nailtosun/Thermal-Analysis/README.md

# Tübitak'a yazılacak rapor başlıkları
## Termal Toplu Öğeli Devre (Lumped parameter)
### Foster Model
### Cauer Model
## Konveksiyon Katsayısının Belirlenmesi
## Sonlu Elemanlar Analizinin Yapılması
## Termal Deneyle Sonlu Elemanlar Analizinin karşılaştırılması
