nailtosun/Thermal-Analysis/STAR-2018/Poster/Nail_Poster.pptx

Thermal Modelling of IMMD Structure and Heat-Sink Design

Nail Tosun
(nail.tosun@metu.edu.tr)

Abstract

The power losses on the motor drive circuit occur as thermal pressure on the motor drive. As a result, the temperature of the motor-driver board may increase and the drive may disturb the operation may cause permanent damage to the circuit elements (particularly transistors). A cooler must be used in order to effectively remove the heat energy generating from power losses. The aim of this project is to construct a thermal model and design a heatsink to 7.5kW Integrated Modular Motor Driver system. The physical properties of the cooler are important here. If the heat sink is produced longer than necessary, increased motor size causes a reduction in the power density. On the other hand, a heat sink designed shorter than necessary puts the operation at risk. In the heat sink design, lumped parameter thermal circuit modeling was performed at first, then the required thermal resistance of the heat sink is calculated as a result of the analysis on this model.

Thermal Path on Drive Side

Lumped Parameters and
Heat Sink Design

Since the heat sinks are quarter slice shaped instead of rectangular and the fan size is smaller than heat sink size
- L, air traveling distance
- V, air flow speeds
are different at each wing. Both variables are calculated by taking the average of all values. h was calculated as 18.36 W / m-K. According to this calculated value, the heat sink fin length was determined, appropriate aluminum profiles are taken accordingly and they were cut as desired by using water jet.

Mesut Uğur
(ugurm@metu.edu.tr)

PowerLab Research Group, METU, ANKARA

Ozan Keysan
(keysan@metu.edu.tr)

FEA and Test Results

Testing was carried out by using metal resistors on the heat sink and at the same time, model verification is tried to be done by using FEA. Metal resistors have a total power rating of 44.1 W. Measurements were recorded with a thermal camera at an ambient temperature of 18.3°C

Heat Convection Coefficient Calculations

Optimization of the fin height

Conclusion

Steady state analysis is carried out in only resistive network model for the thermal equivalent circuit modelling and calculating convection coefficient. Convection coefficient is computed first using lumped parameter method. According to this calculated value, the heat sink fin height was determined, appropriate aluminum profiles are taken accordingly and heat sinks are produced. Obtained results are tested and verified using FEA method. Further analysis and design is made again using FEA in order to obtain a smaller fin height value and increase the power density. Finally, comparing to the first result, an optimized and better result in terms of power density is obtained which is 2 cm.

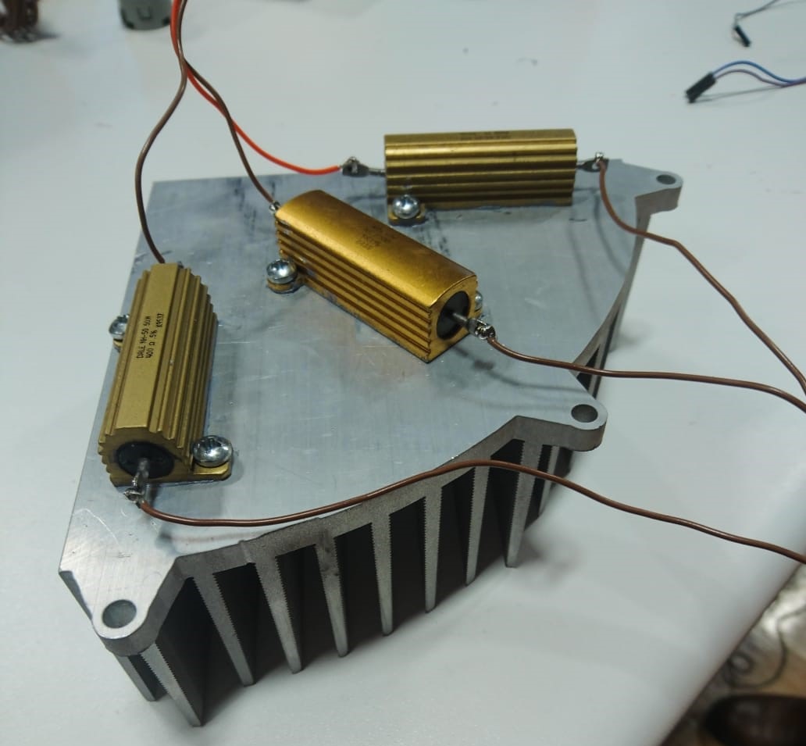
[picture p1: figure]

Test setup

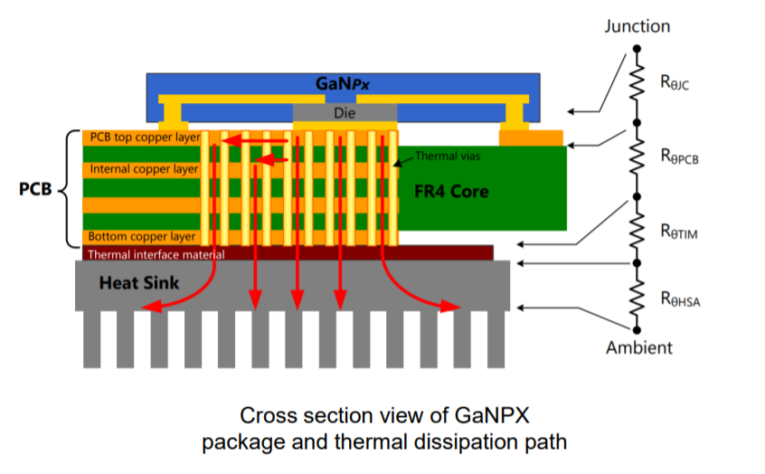
[picture p2: figure]

In this model, P_(loss) is the power loss of each GaN transistor, T_j , T_c , T_(pcb) , T_(hs) and T_a are junction, package, printed circuit board, cooler base and ambient temperature respectively. Resistances refer to the thermal resistance between the two points.

R_(hs) = 1/(h(A_(base) +N_(fin) η_(fin) A_(fin) ))

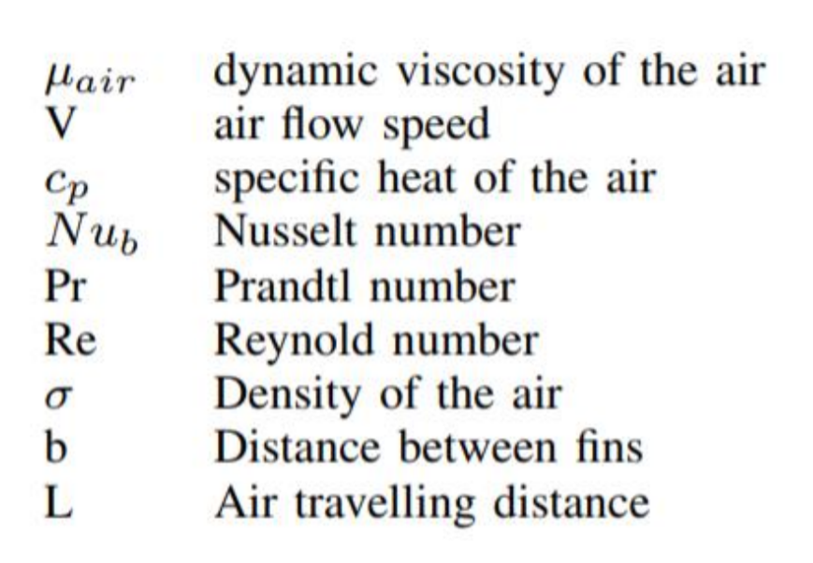
[picture p3: figure]
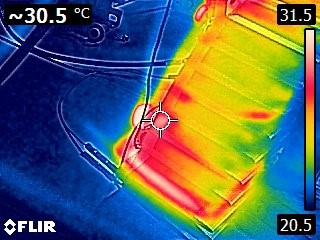
[picture p4: figure]
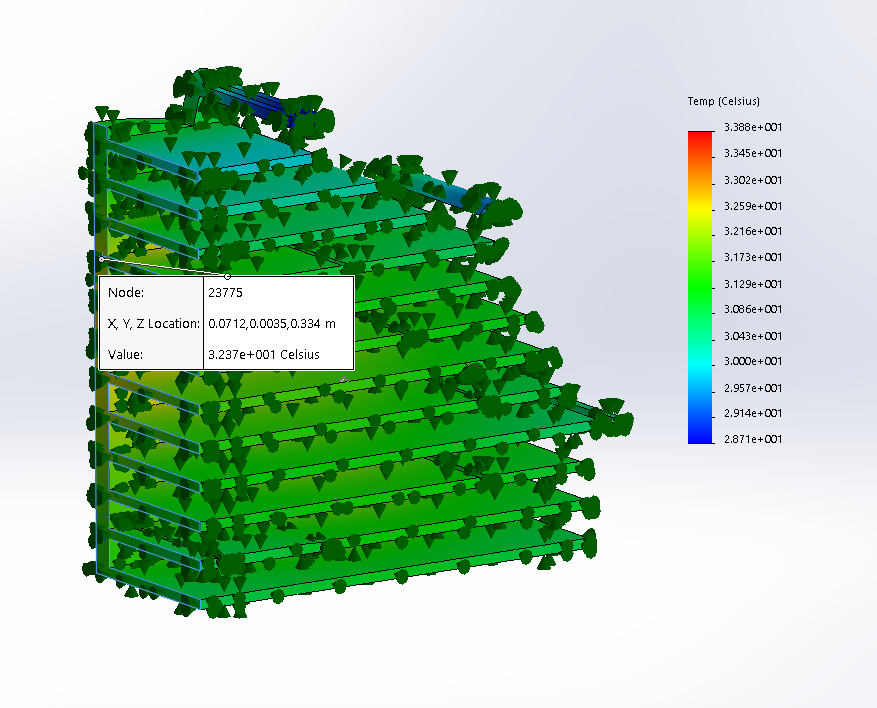
[picture p5: figure]
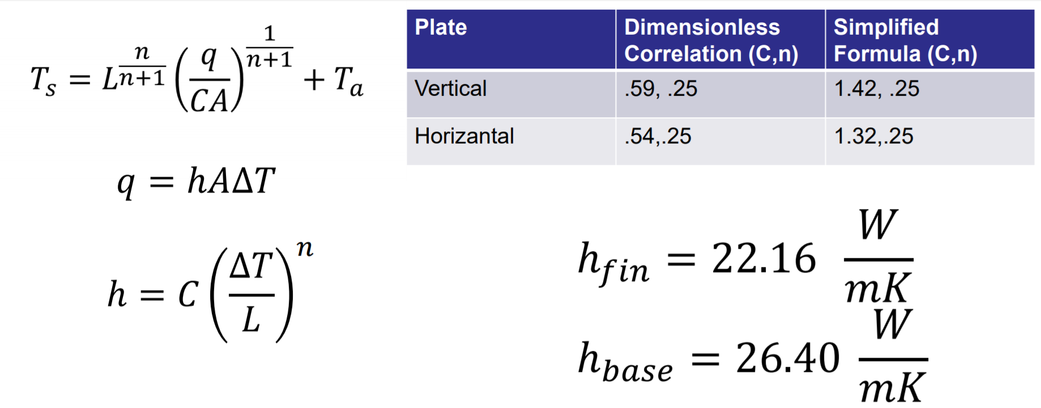
[picture p6: figure]

Test results

FEA results

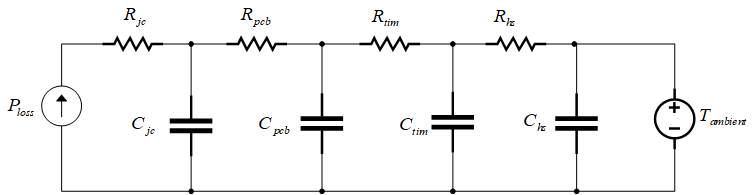
[picture p7: figure]
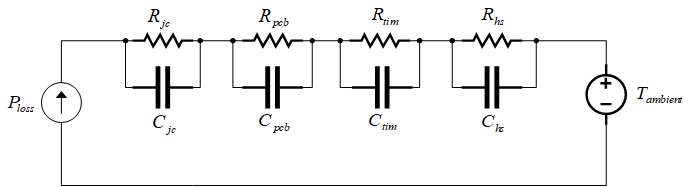
[picture p8: figure]

Cauer Model

Foster Model

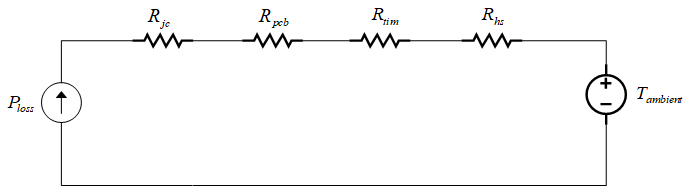
[picture p9: figure]

Only Resistive Network

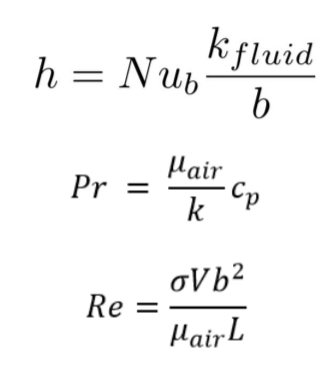
[picture p10: figure]

Constant C,n values

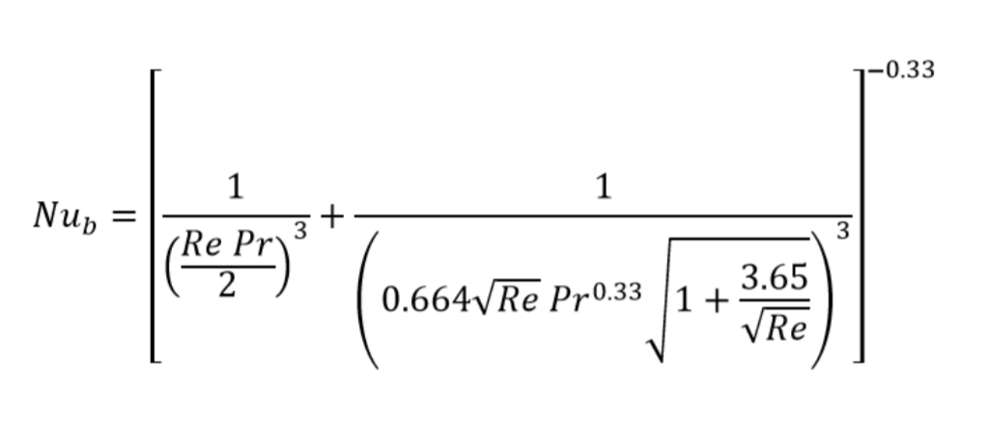
[picture p11: figure]
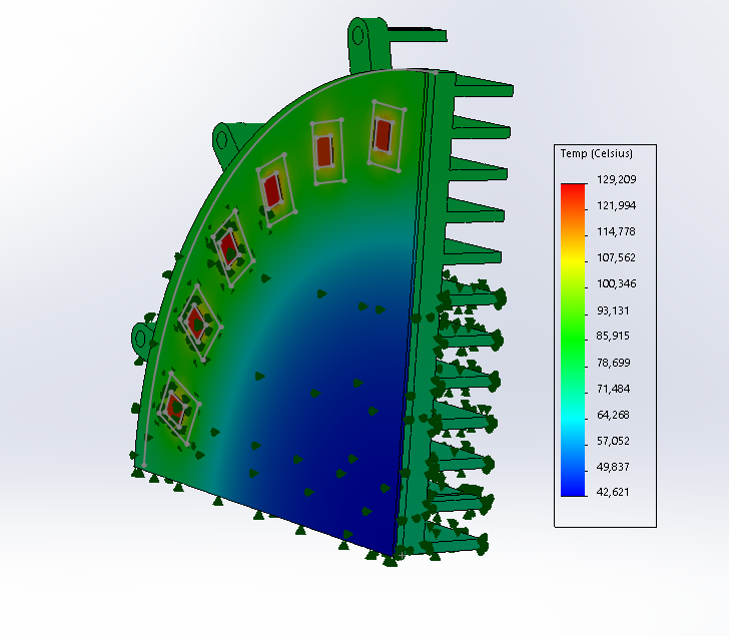
[picture p12: figure]
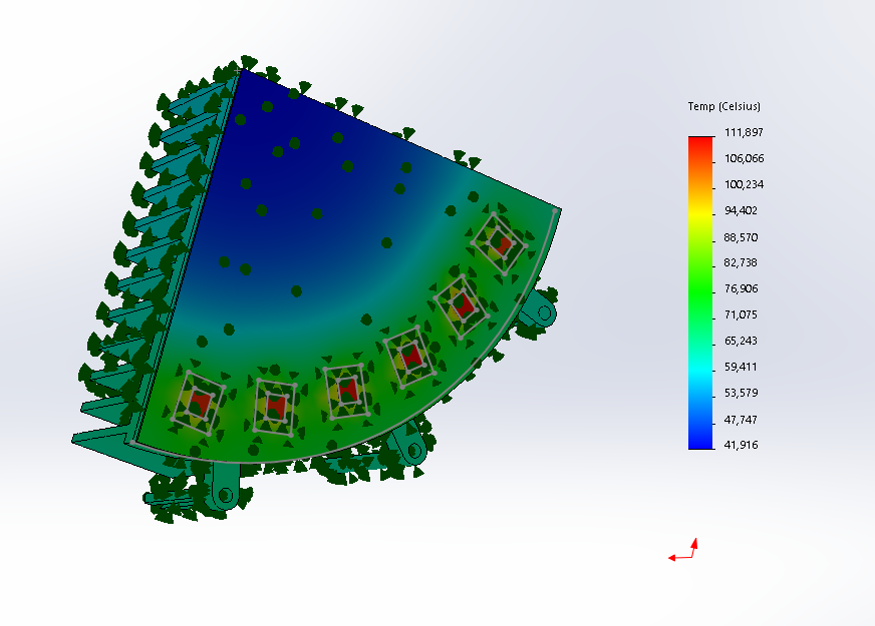
[picture p13: figure]
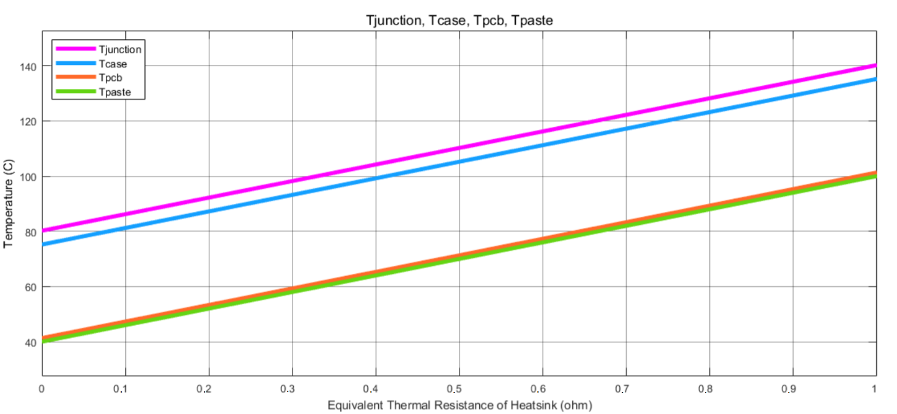
[picture p14: figure]
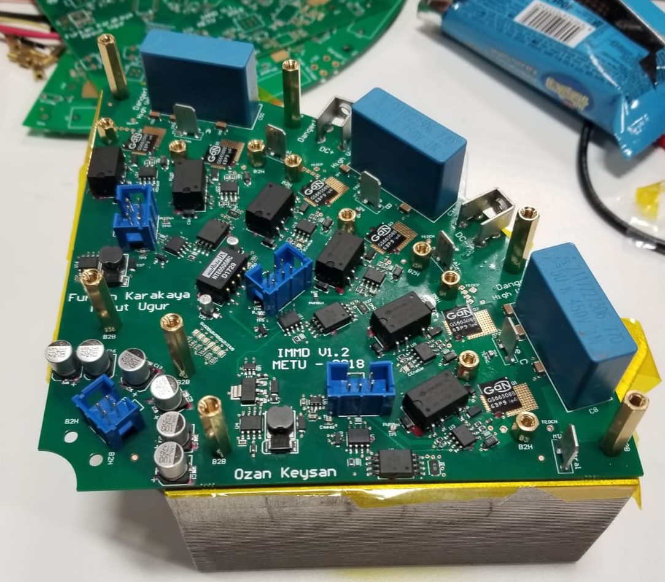
[picture p15: figure]

PCB with heat sink

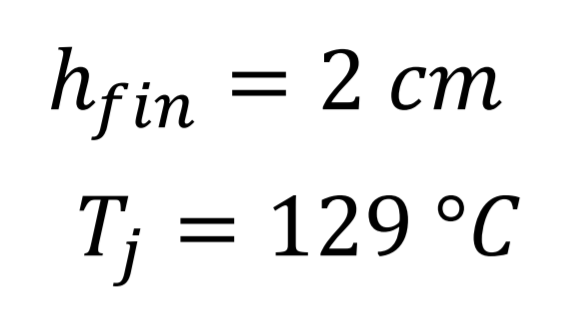
[picture p16: figure]
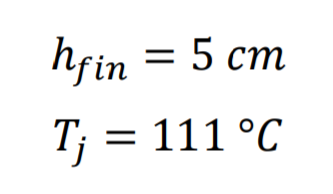
[picture p17: figure]

References

[1] GaN Systems, “PCB Thermal Design Guide for GaN Enhancement Mode Power Transistors” Application Notes, 2018.
[2] ncropera, F.P., and DeWitt, D.P., Fundamentals of Heat and Mass Transfer, John Wiley and Sons, New York, NY, 1985.
