nailtosun/Thermal-Analysis/22-04-presentation.pptx

## IMMD Termal Simülasyonu

## Fin height vs Heat Convection Coefficent

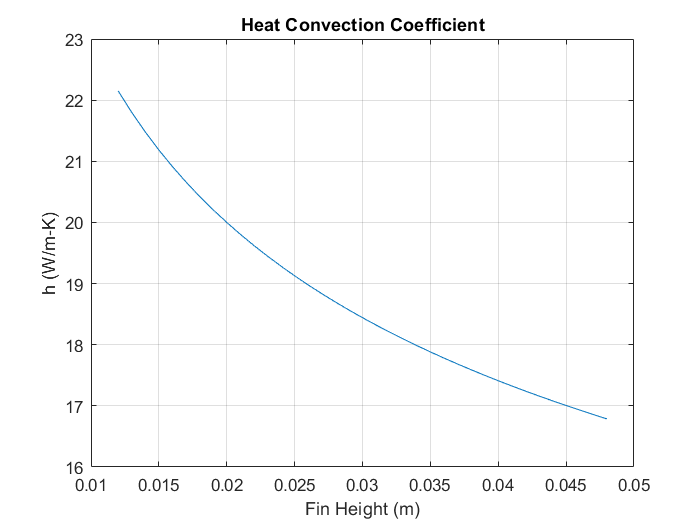
[picture p18: figure]
metin içeren bir resim Açıklama otomatik olarak oluşturuldu
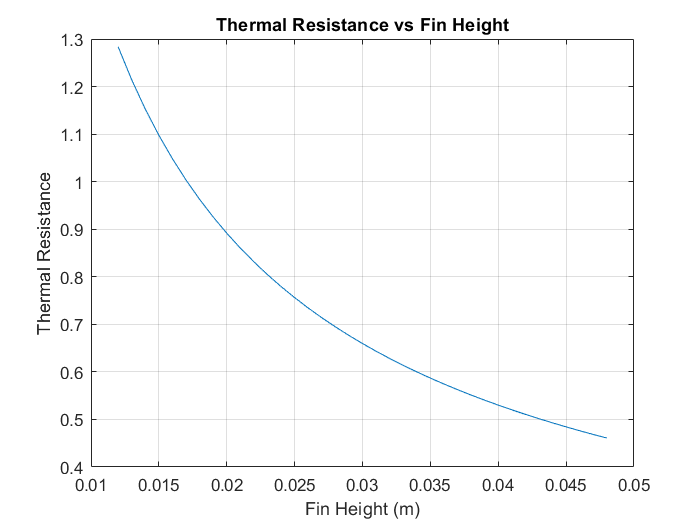
[picture p19: figure]
metin içeren bir resim Açıklama otomatik olarak oluşturuldu

## Study 1 (4.8 cm fin)

- hfin = 17 W/m-K
- Ambient temperature 20 Celcius
- Loss, 6,5 Watt per GaN

## Slide 4

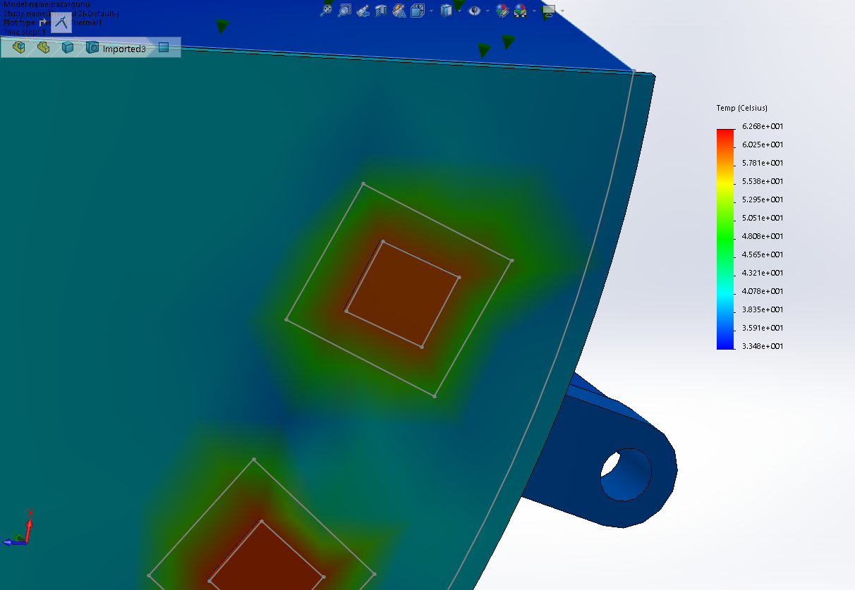
[picture p20: figure]
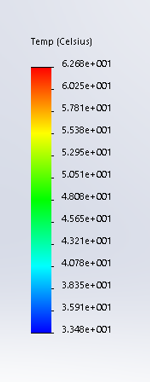
[picture p21: figure]

## Slide 5

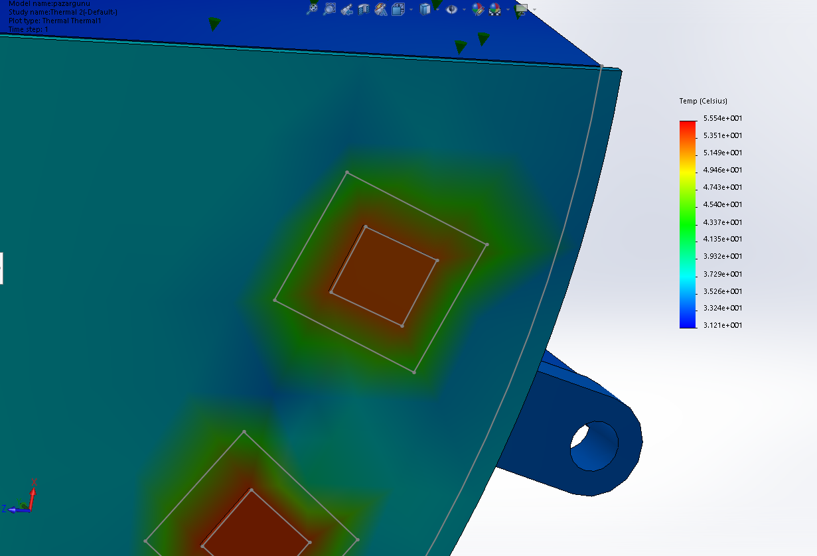
[picture p22: figure]
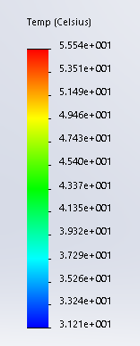
[picture p23: figure]

## Study 2 (4.8 cm fin)

- hfin = 17 W/m-K
- Ambient temperature 40 Celcius
- Loss, 5,4 Watt per GaN

## Slide 7

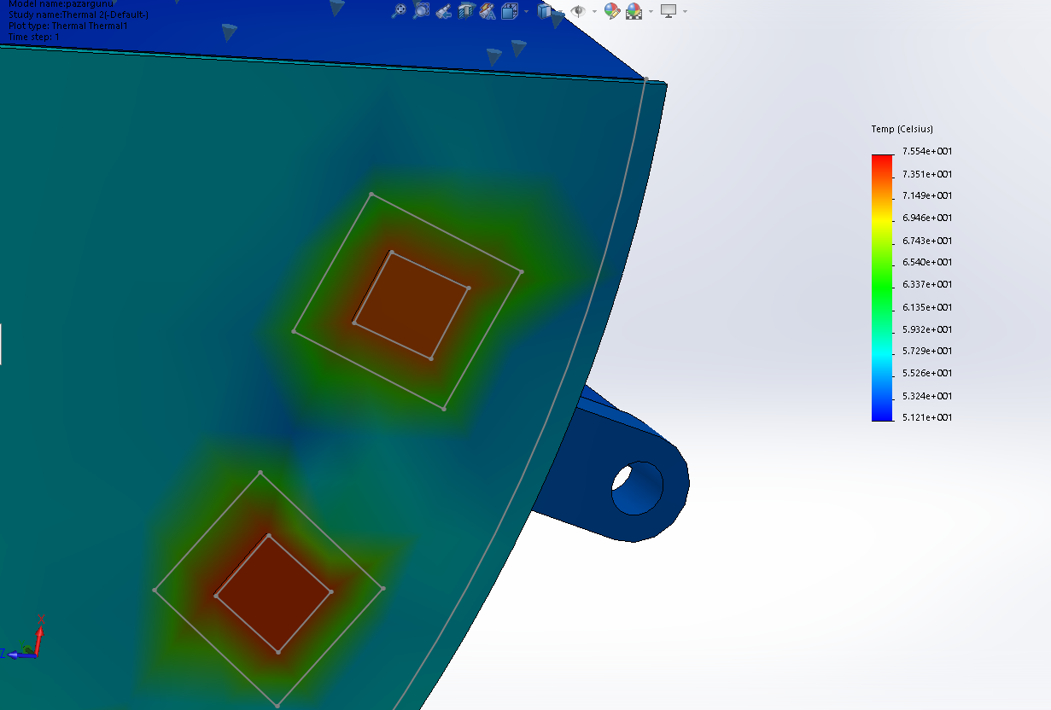
[picture p24: figure]
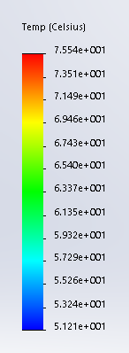
[picture p25: figure]

## Slide 8

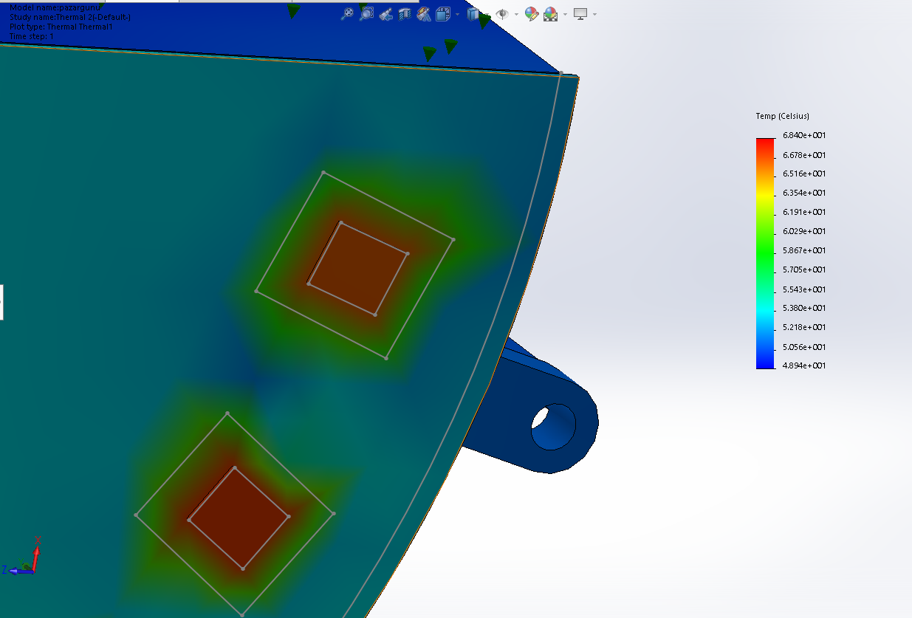
[picture p26: figure]

## Study 3 (2.4 cm fin)

- hfin = 19.2 W/m-K
- Ambient temperature 40 Celcius
- Loss, 6,5 Watt per GaN

## Slide 10

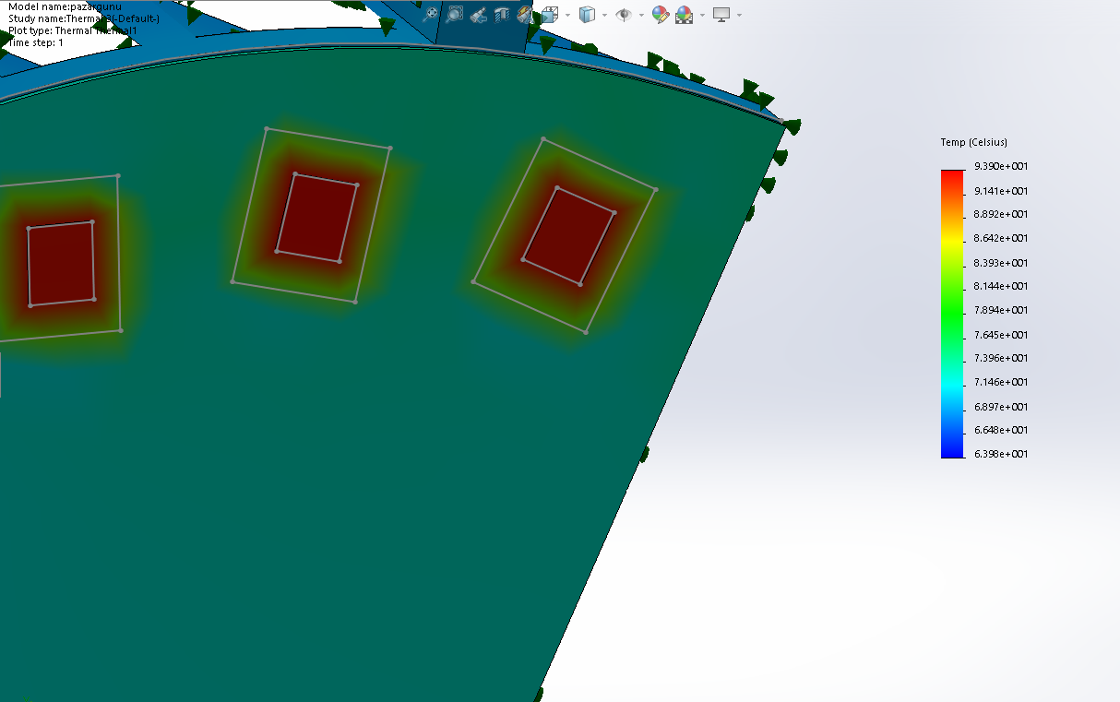
[picture p27: figure]
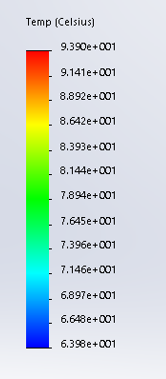
[picture p28: figure]

## Slide 11

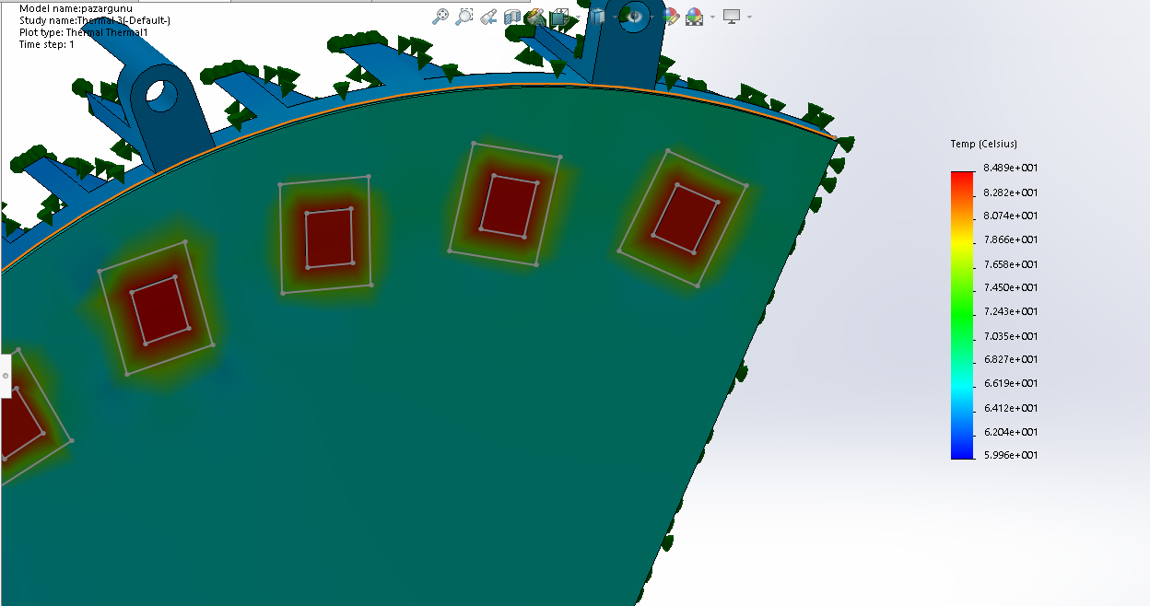
[picture p29: figure]
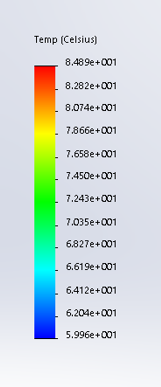
[picture p30: figure]
