nailtosun/Thermal-Analysis/FEA-1012.pptx

## Thermal FEA

## Slide 2

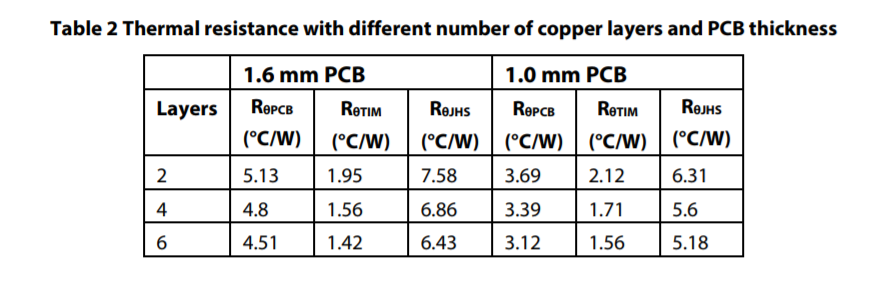
[picture p31: figure]
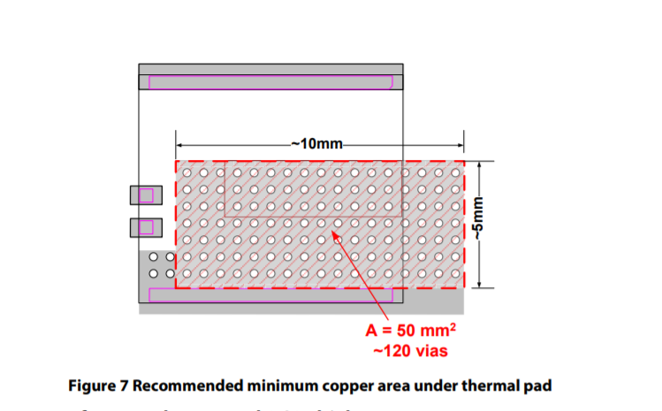
[picture p32: figure]

R_(pcb) =l/(ρA)

ρ=l/(R_(pcb) A)

ρ= 5.8997 W/m-K

## Slide 3

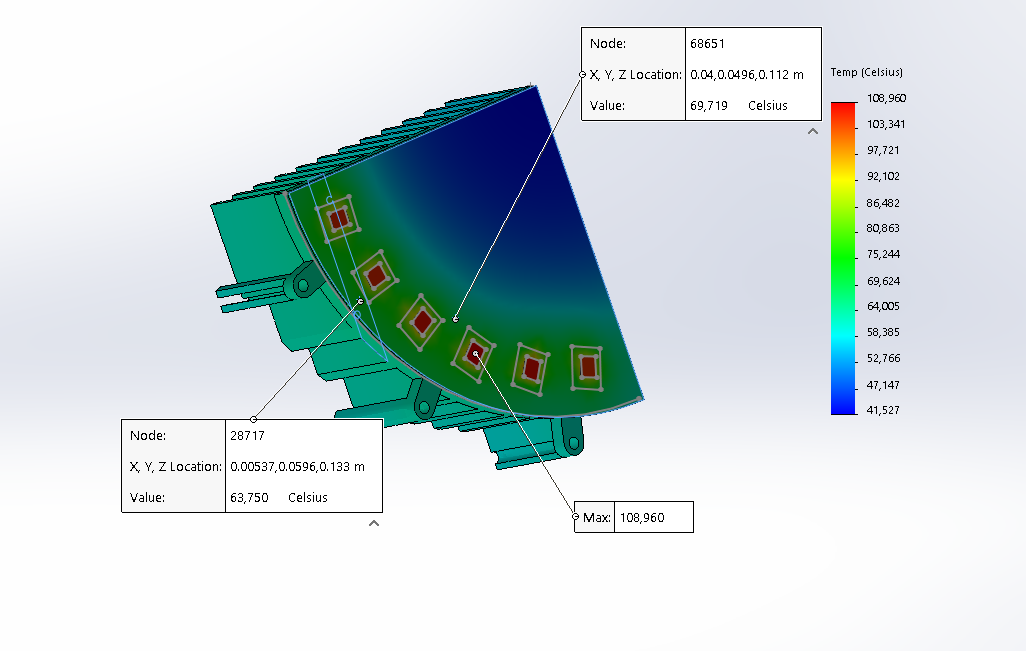
[picture p33: figure]

P_(GaN) =10 W

T_(amb) = 40 C^o

h_(fe) =18W/(m−K )

h_(be) =5W/(m−K )

## Slide 4

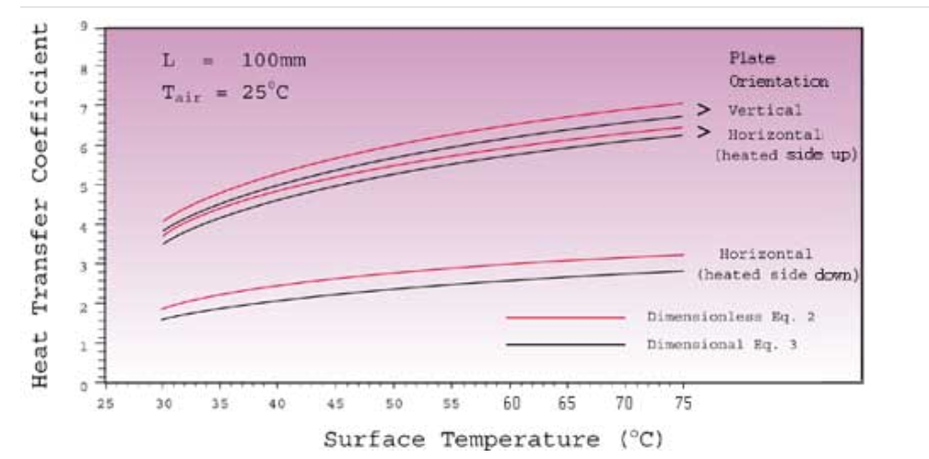
[picture p34: figure]

## Slide 5

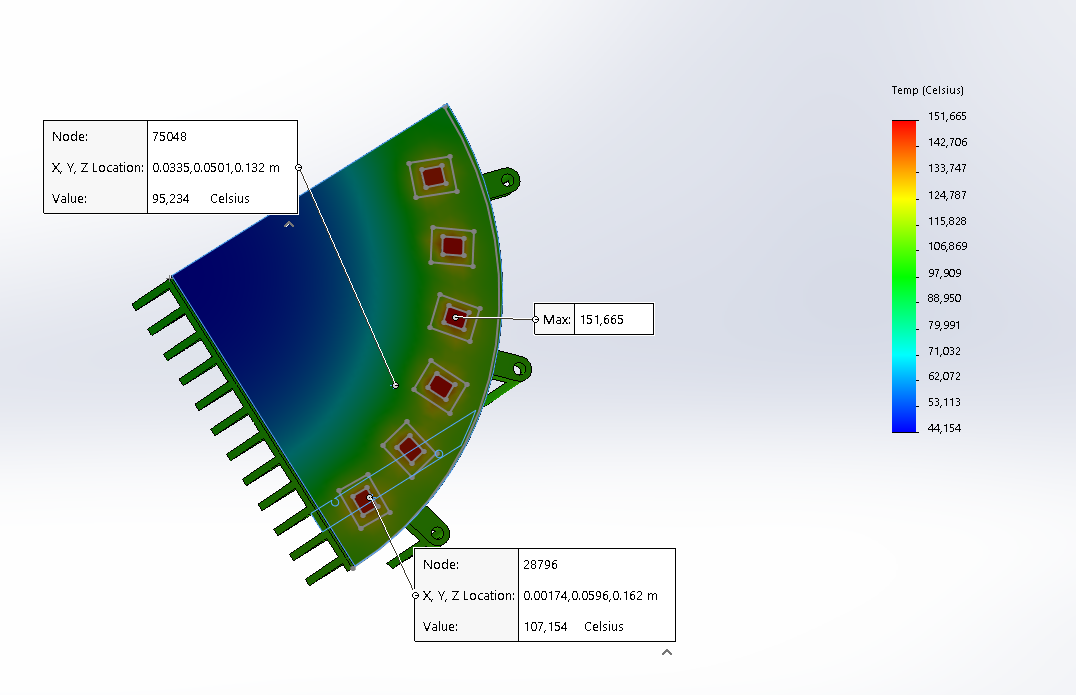
[picture p35: figure]

h_c =5W/(m−K )

P_(GaN) =10 W

T_(amb) = 40 C^o

## Slide 6

h_c =5W/(m−K )

P_(GaN) =10 W

T_(amb) = 40 C^o

## Slide 7

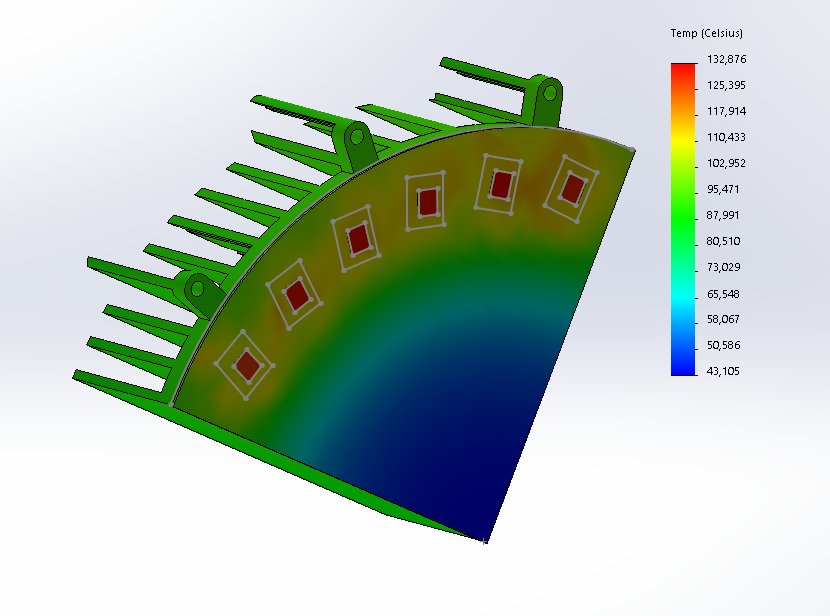
[picture p36: figure]

h_c =6W/(m−K )

P_(GaN) =10 W

T_(amb) = 40 C^o

## Estimating natural convection for heat-sink

- h_(fin)
- h_(base)

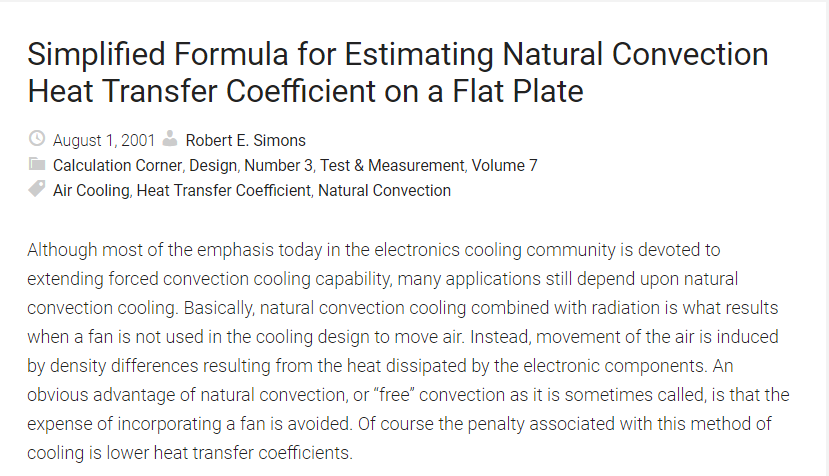
[picture p37: figure]
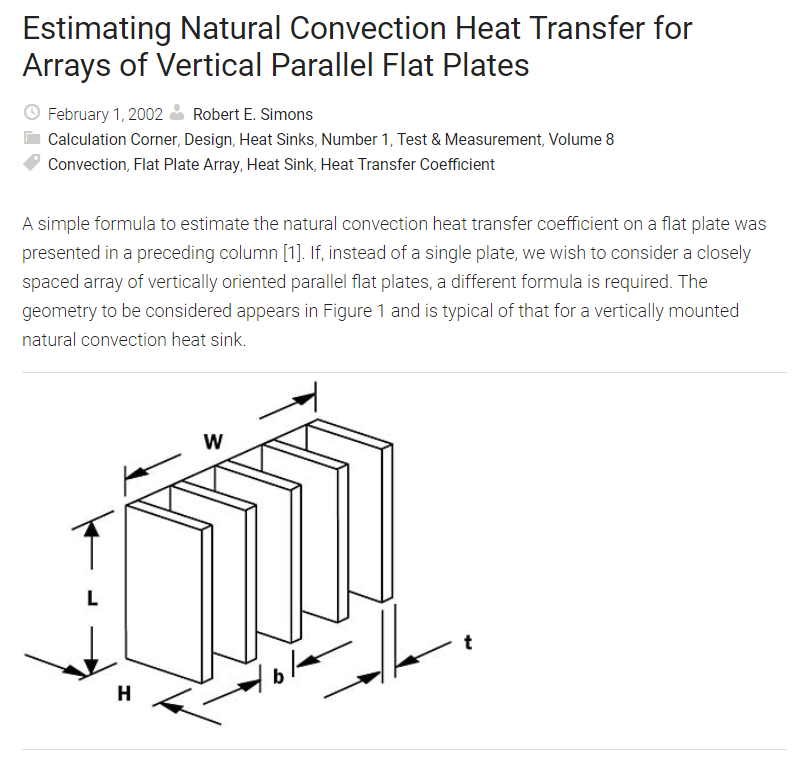
[picture p38: figure]

## Estimating natural convection for heat-sink

- Simplified Formula for h
- Dimensionless Correlation

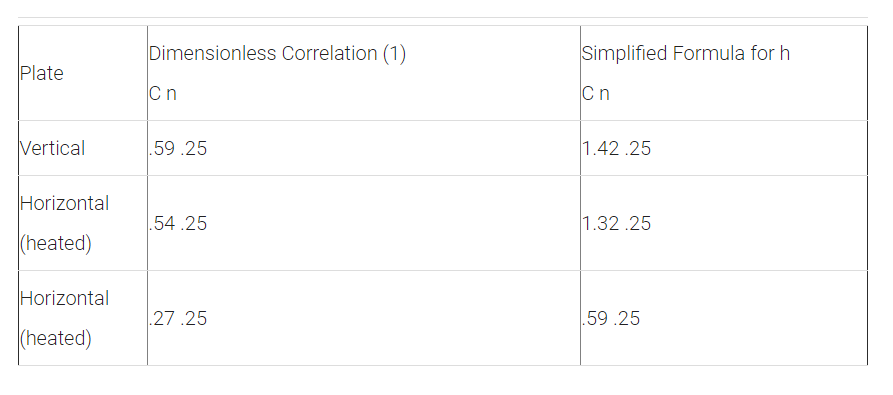
[picture p39: figure]

## Slide 10

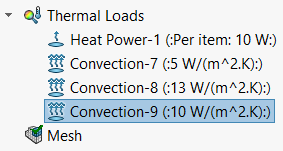
[picture p40: figure]
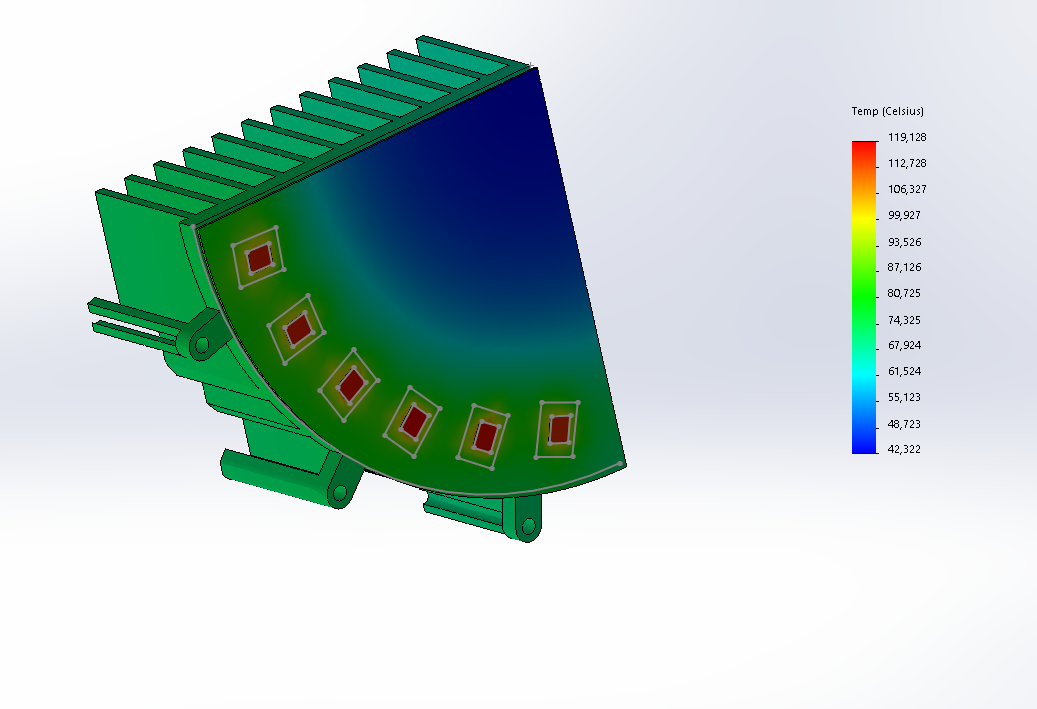
[picture p41: figure]
