nailtosun/Thermal-Analysis/Presentations/FEA-24-12.pptx

## The effect of Fin Height on Natural Convection Coefficient

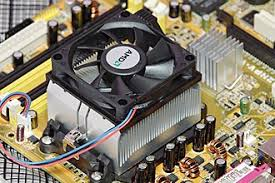
[picture p42: figure]
heat sink ile ilgili gÃ¶rsel sonucu

## Estimation of Natural Convection Flat surfaces (Base of the heat sink)

- Two method proposed
  - Dimensionless Number Correlations
    - Boundary condition (Surface temperature needed.)
  - Simplified formula (Comes from DNC &Newton rate equation)
    - Boundary condition estimated

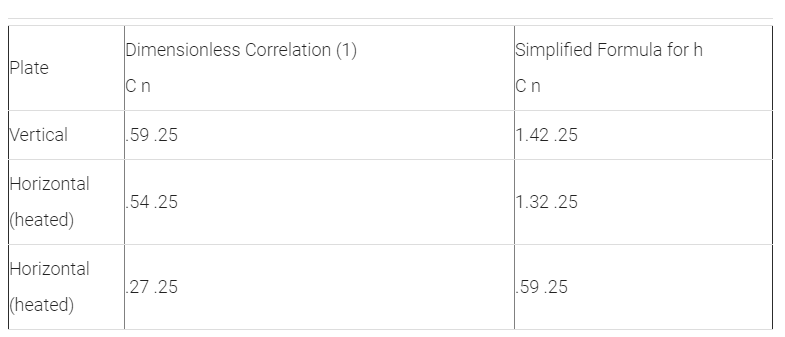
[picture p43: figure]

T_s = surface temperature

q = Heat power entering the surface

L = Vertical length of the solid

C and n are constants

## Estimation of Natural Convection Flat surfaces (Base of the heat sink)

- Last time I used DNC
  - Boundary conditions are guessed last time
- Now, surface temperature founded by simplified formula

Assumptions
- Fins are normalized
- All heat splitted equally

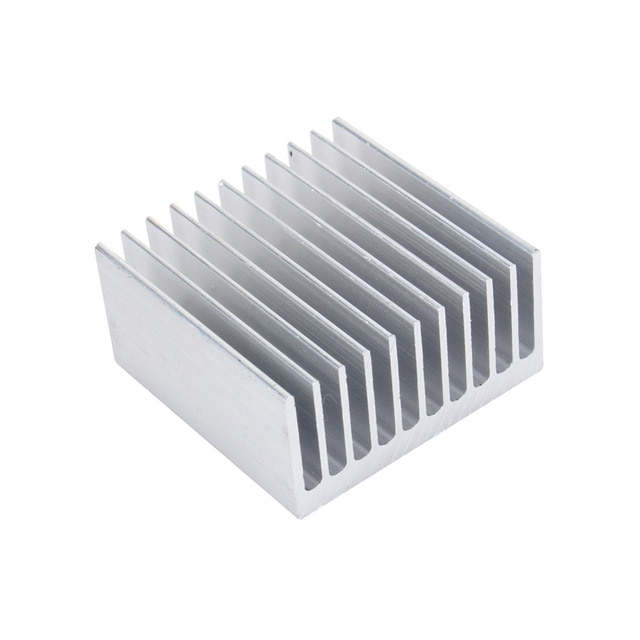
[picture p44: figure]
heat sink ile ilgili gÃ¶rsel sonucu

## Slide 4

With current geometry
  - h_(fin) =22.16 W/(mK)
  - h_(base) =26.40 W/(mK)

metin içeren bir resim Açıklama otomatik olarak oluşturuldu

The reason for fin efficieny?

metin içeren bir resim Açıklama otomatik olarak oluşturuldu

## Slide 5

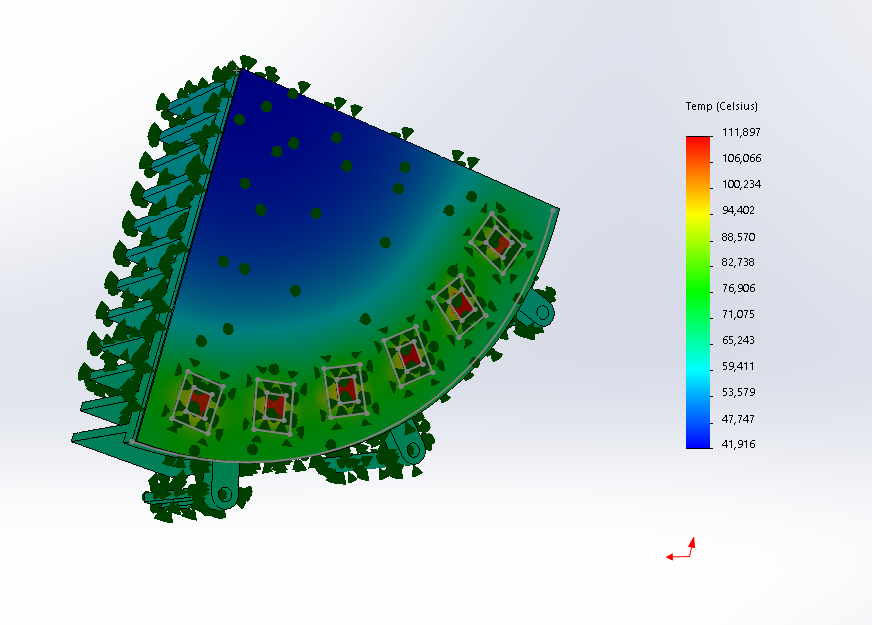
[picture p45: figure]
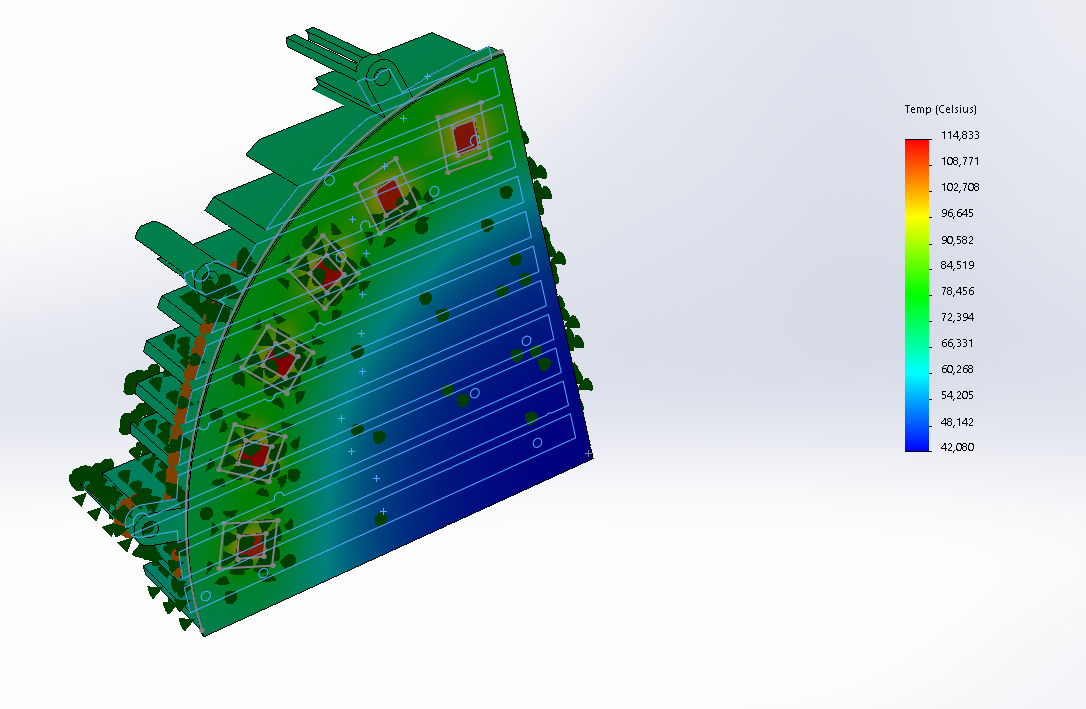
[picture p46: figure]

Fin height = 4.8 cm

Fin height = 3.8 cm

## Slide 6

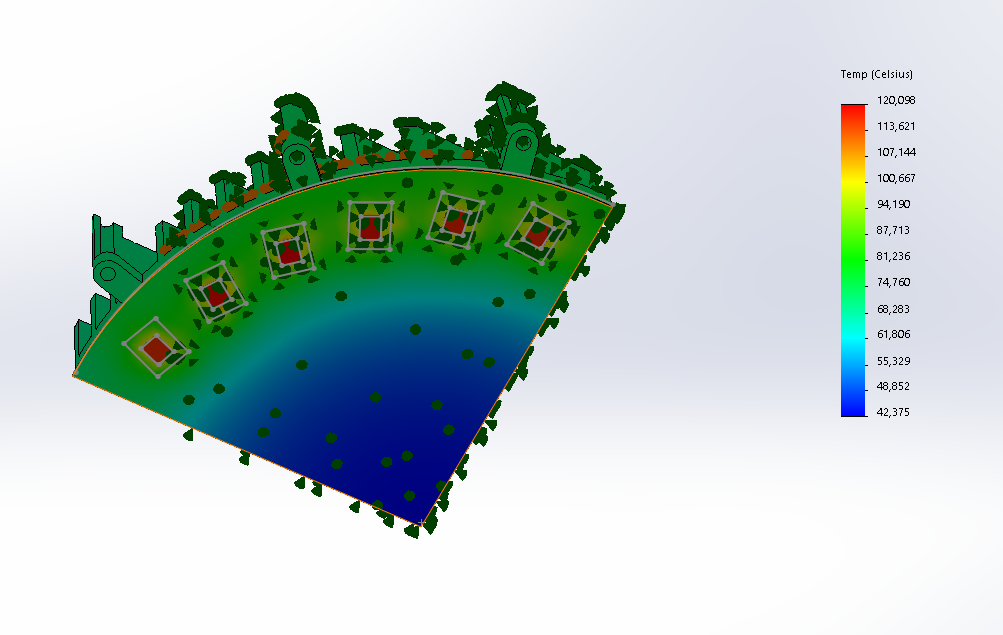
[picture p47: figure]

Fin height = 2.8cm

## Slide 7

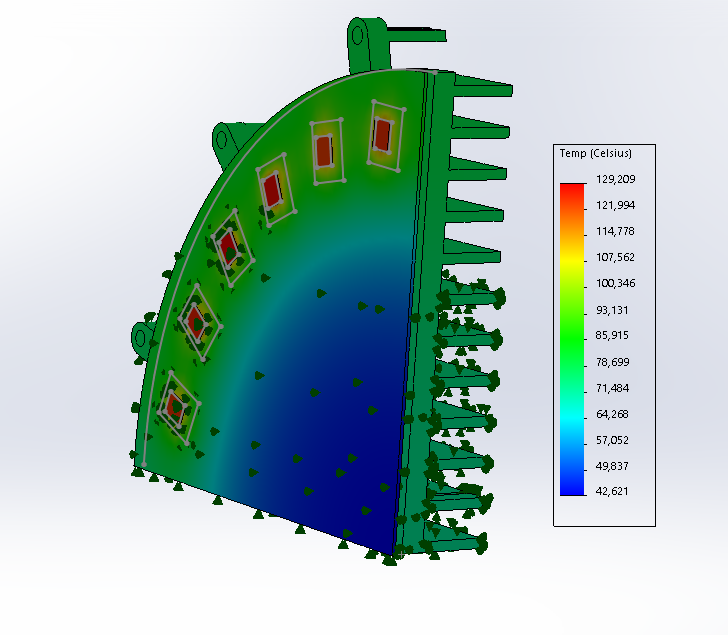
[picture p48: figure]

Fin height = 2 cm
