nailtosun/Thermal-Analysis/Presentations/15.10.2018.pptx

## Thermal Analysis

## Convection Coefficient

12 Volt
Sections | Air Flow
1 | 1.84
2 | 2.06
3 | 2.06
4 | 1.86
5 | 1.43
6 | 1.36
7 | 1.3

- h = 18.36 W/m-K
Assumptions;
- Taking averages of fin air flow speeds.
- Not rectangle shape,normalization.
- Average speed = 1.7 m/s

## Setup

Voltage (Volts) | Air Flow (m/s)
12 | 3.54
11 | 3.28
10 | 2.94
9 | 2.73
8 | 2.32
7 | 1.96
6 | 1.65
5 | 1.24

- 3 heat source (2x 400ohm and 1 500 ohm metal resistor)
- Total 44.1 W input power (from power supply)
- Better contact (thermal paste, screwing)
- 12 V DC fan with given voltage air-flow characteristic
- 18^o C ambient temperature

## Base temperature

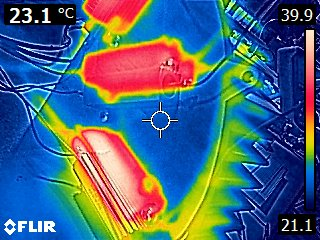
[picture p49: figure]

## Other side

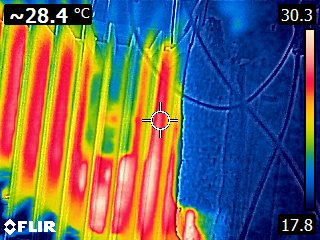
[picture p50: figure]
sabit, yazı gereçleri içeren bir resim Yüksek güvenilirlikle oluşturulmuş açıklama

## Sides

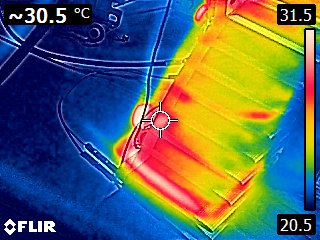
[picture p51: figure]

## Slide 7

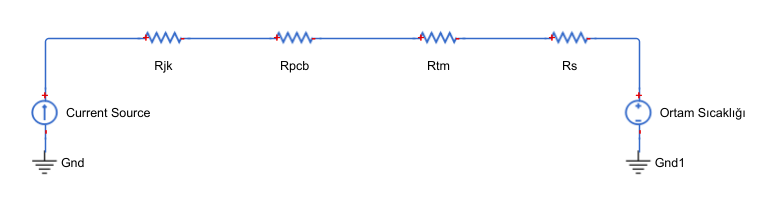
[picture p52: figure]
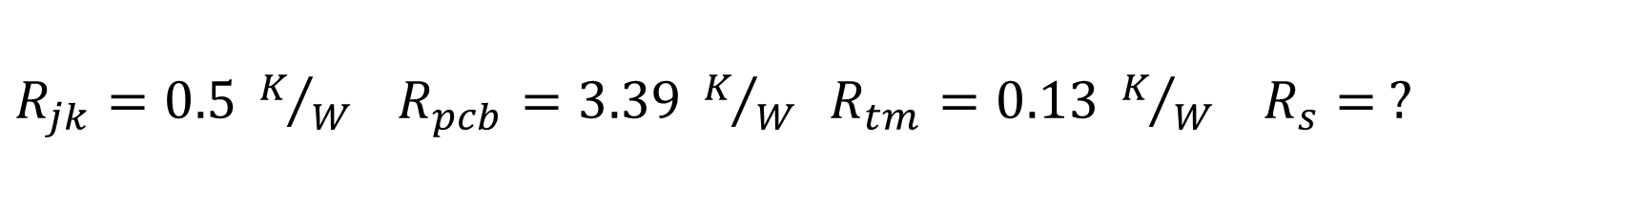
[picture p53: figure]

## Slide 8

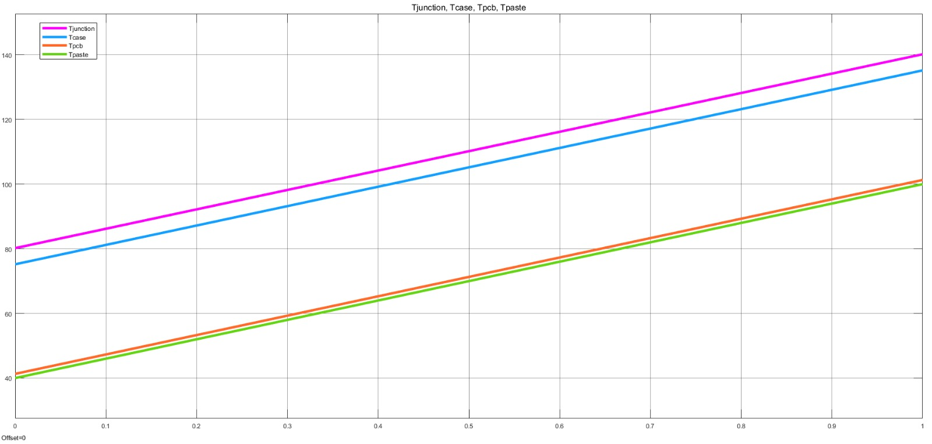
[picture p54: figure]
metin, harita içeren bir resim Çok yüksek güvenilirlikle oluşturulmuş açıklama

## Slide 9

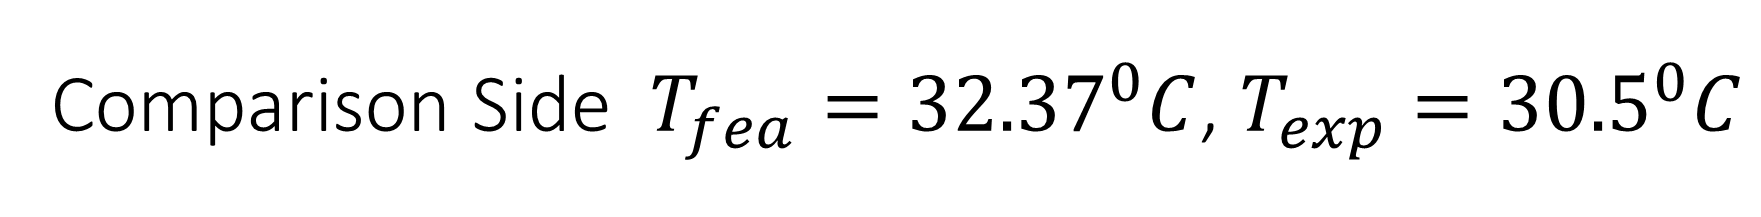
[picture p55: figure]

## Slide 10

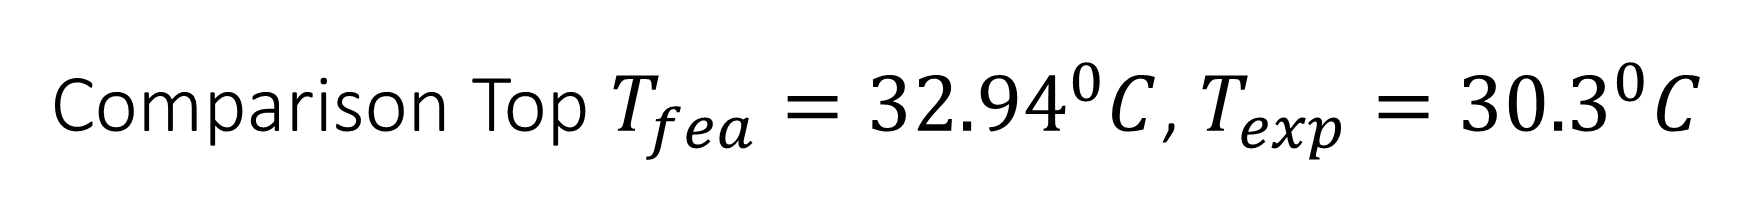
[picture p56: figure]
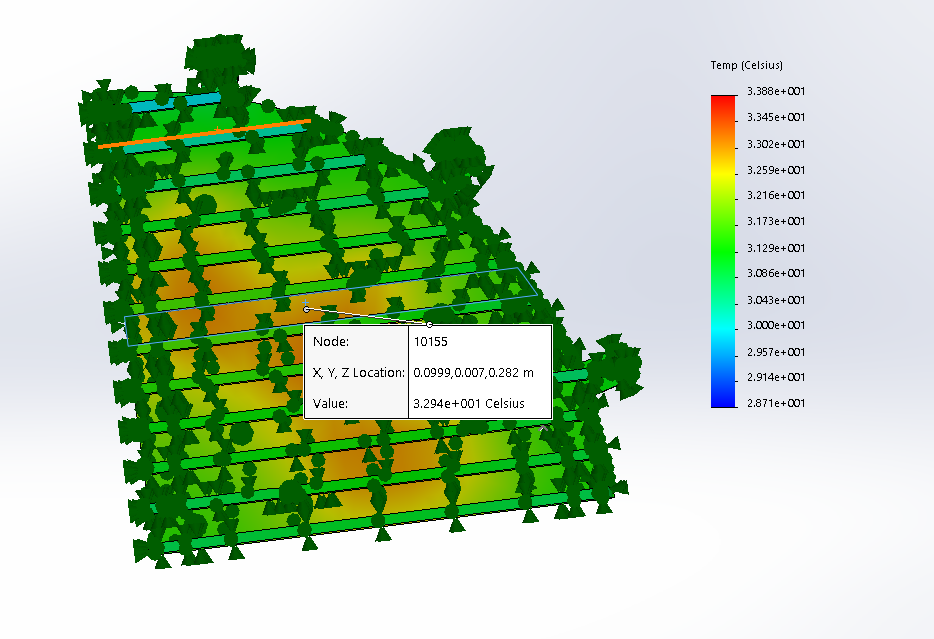
[picture p57: figure]

## Comparison Bottom:
