nailtosun/Thermal-Analysis/Termal FEA simulasyonu.pptx

## Termal FEA simulasyonu

## Prosedür

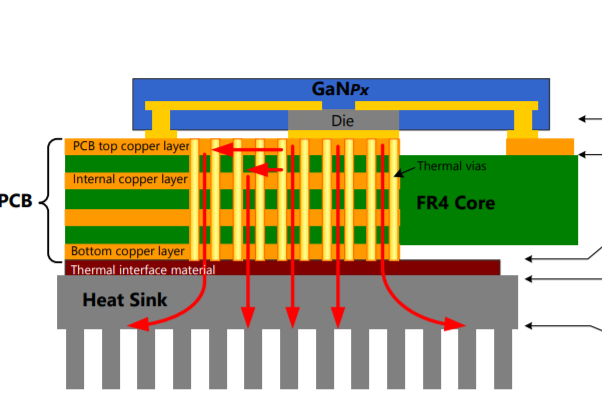
[picture p60: figure]

- 4 parça
  - Soğutucu
    - Materyal alüminyum (Alloy 1060)
    - Isıl iletkenlik 200W/m-K
    - Geometri gerçekle özdeş
  - Termal izolatör
    - Isıl iletkenlik 5 W/m-K
  - PCB
    - Materyal FR-4
    - Isıl iletkenlik 0.29 W/m-K
  - GaN
    - Isıl iletkenlik (büyük >1000W/m-K)
    - Termal direnç kontak yüzeyine atıldı (0.5 K/W)

## Termal Yükler

- Konveksiyon katsayısı
  - 18.3 W/m-k
- Termal güç kaynağı
  - 6 GaN 7 ve 8 Watt (Hacimsel Güç Kaynağı)

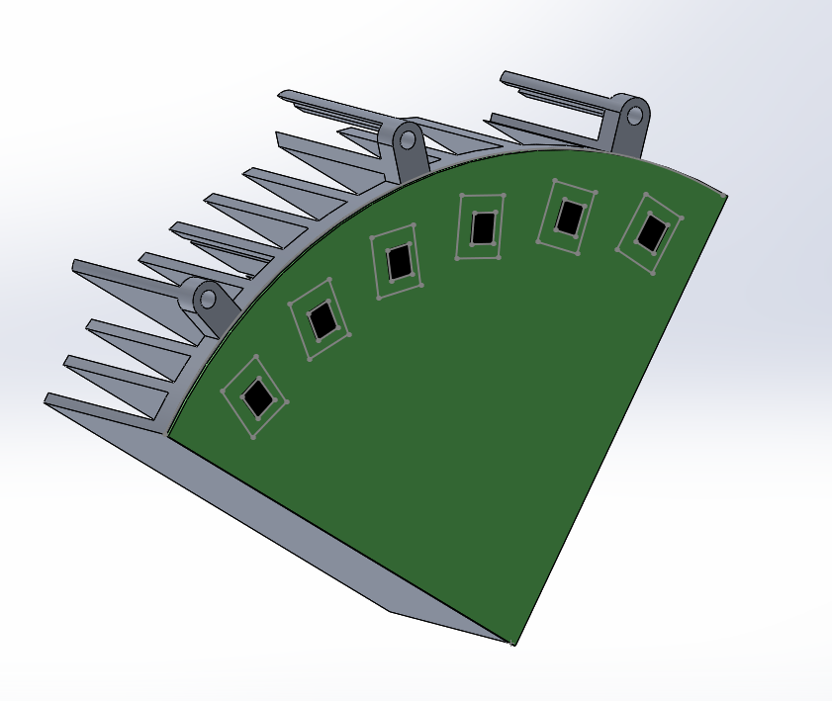
[picture p61: figure]

## Sonuçlar 7 W (her GaN)

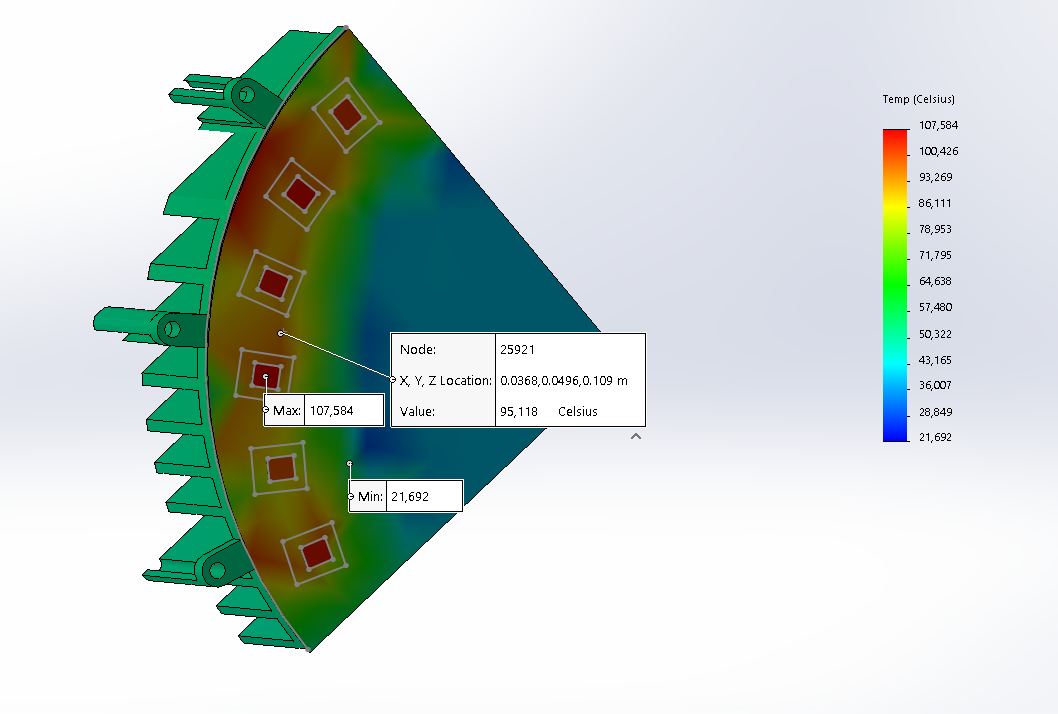
[picture p62: figure]

## Slide 5

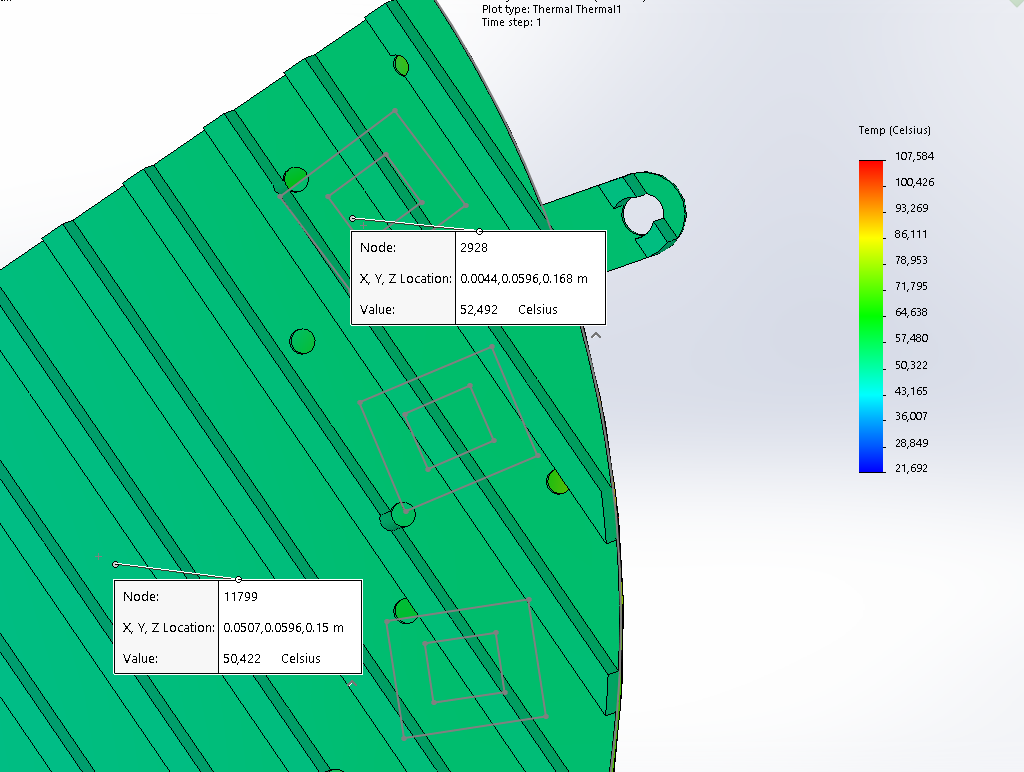
[picture p63: figure]

## Slide 6

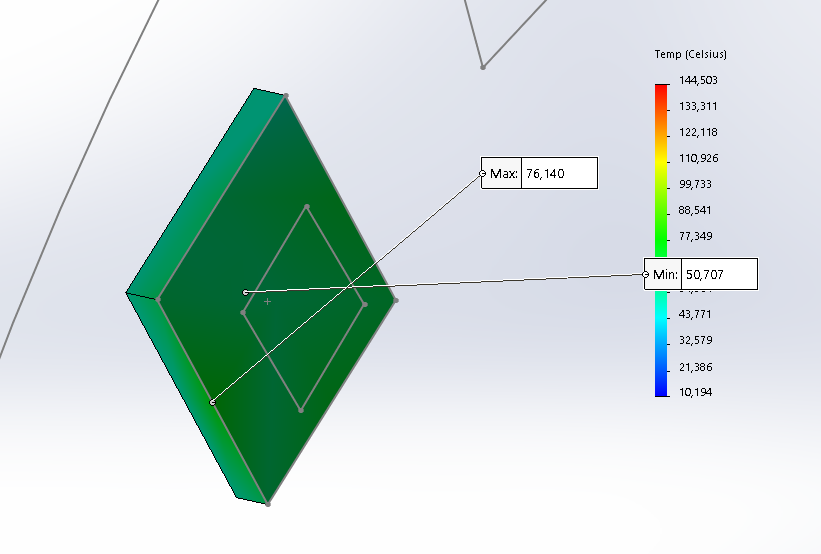
[picture p64: figure]

## Sonuçlar 8 W (her GaN)

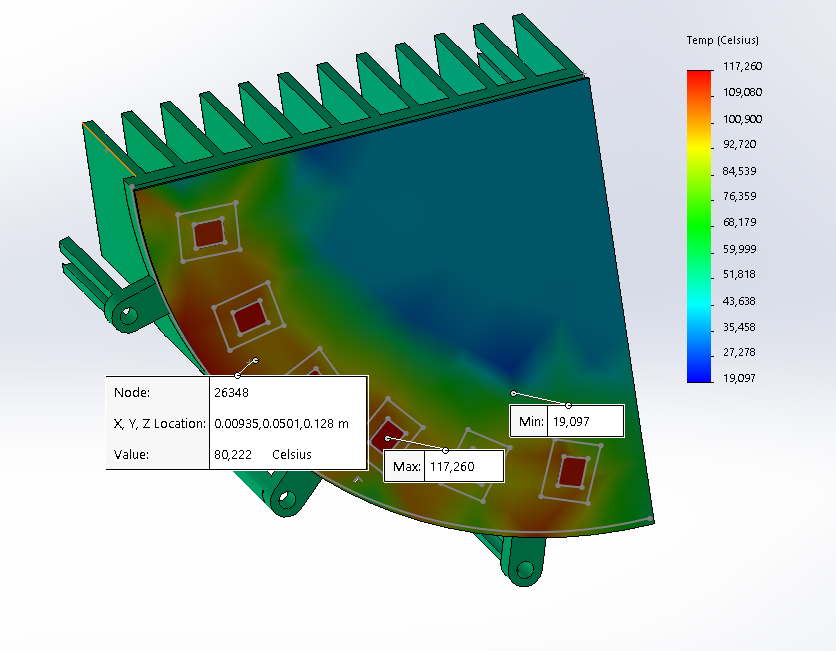
[picture p65: figure]

## Slide 8

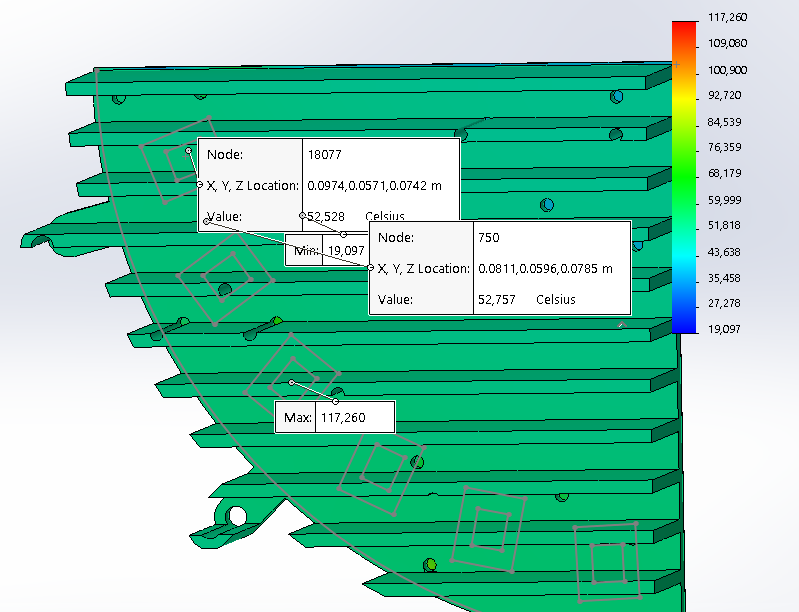
[picture p66: figure]

## Slide 9

Sonuçlar
8 W (her GaN)
2 konveksiyon

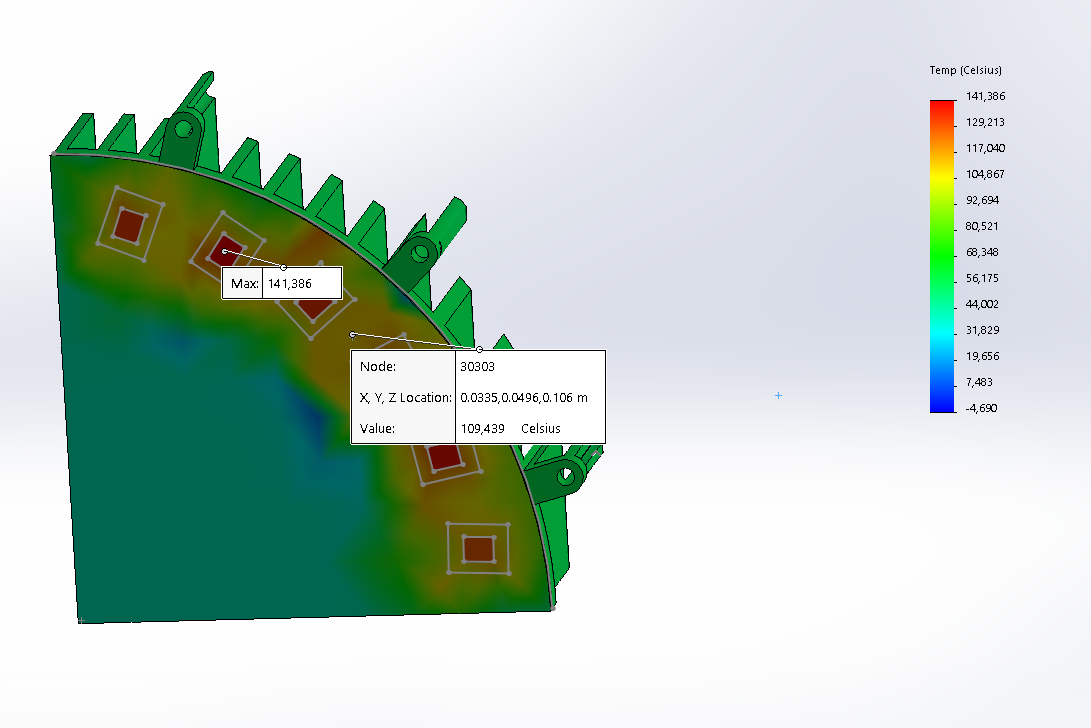
[picture p67: figure]

## Slide 10

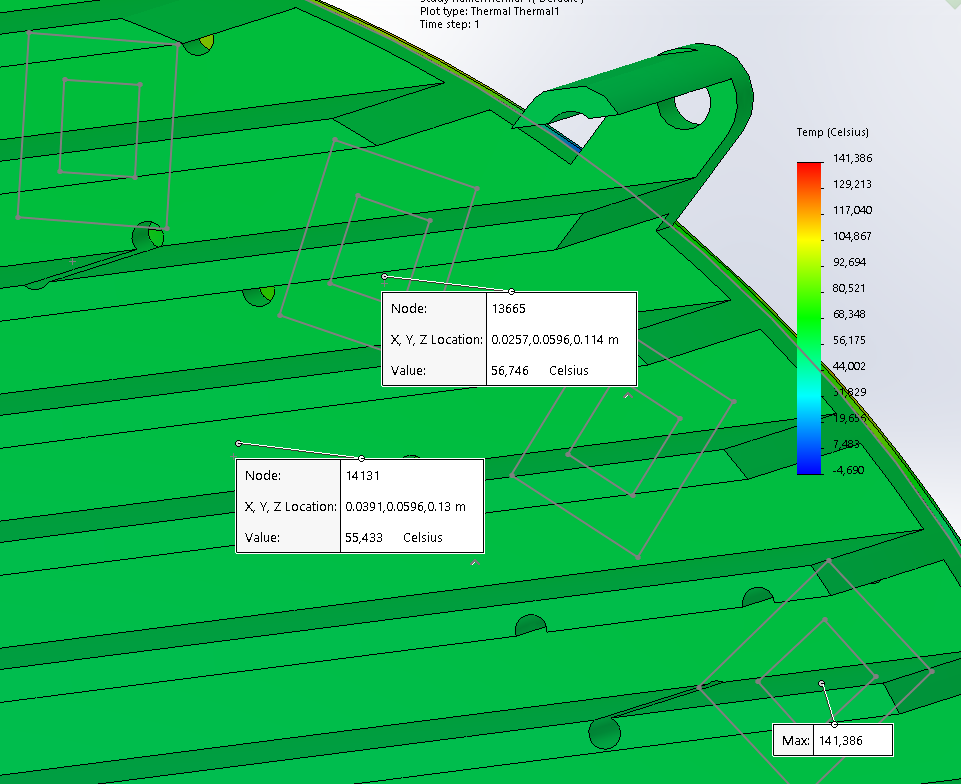
[picture p68: figure]

## Tek konveksiyonlu simülasyonlarda

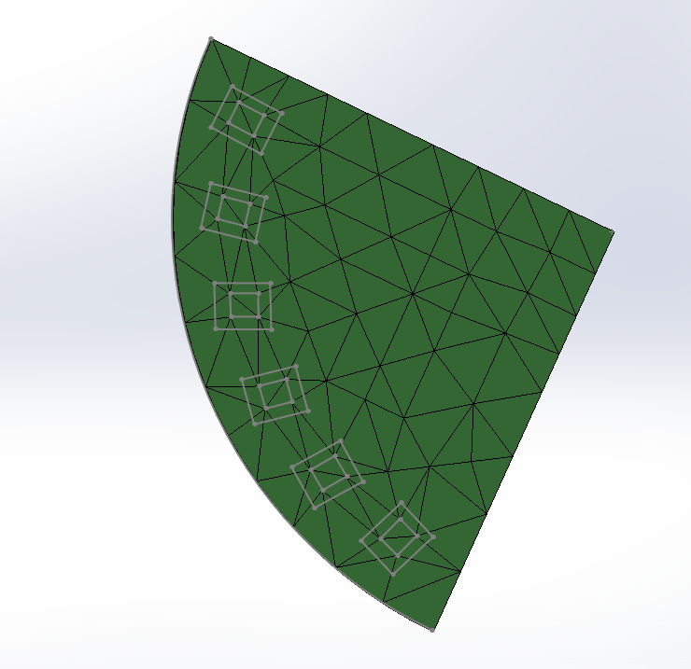
[picture p69: figure]

İki konveksiyonlu simülasyonlarda

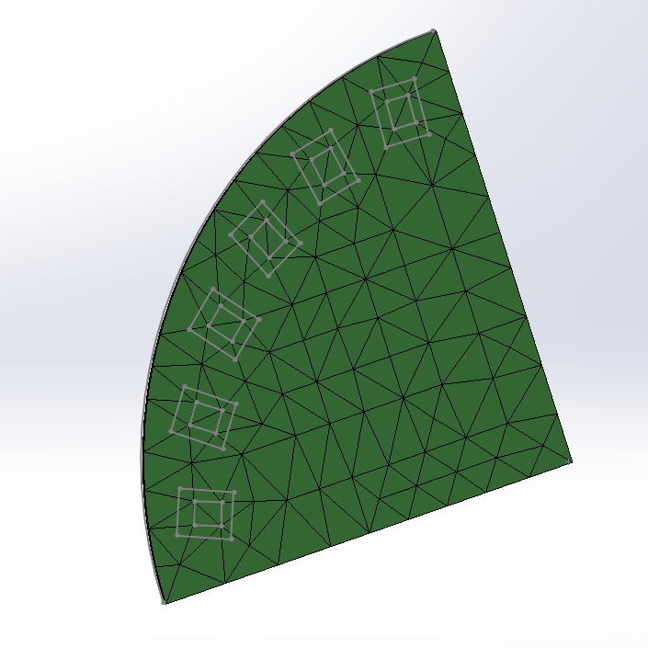
[picture p70: figure]

## Slide 12

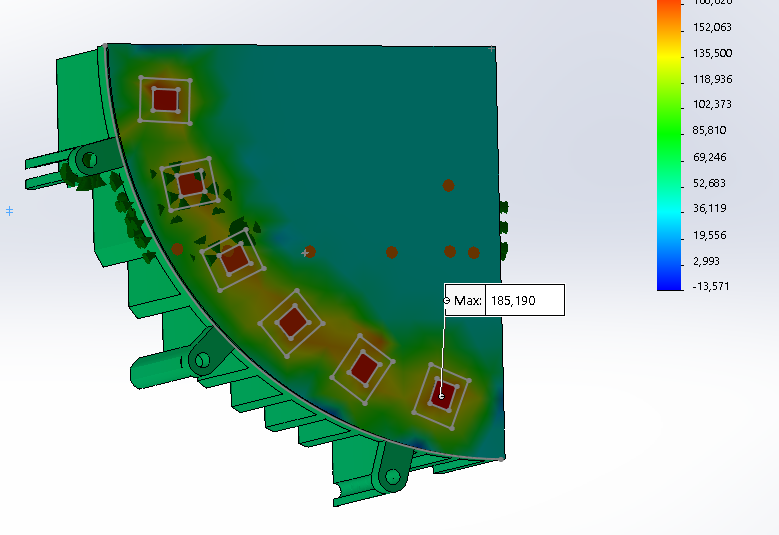
[picture p71: figure]

## Ek

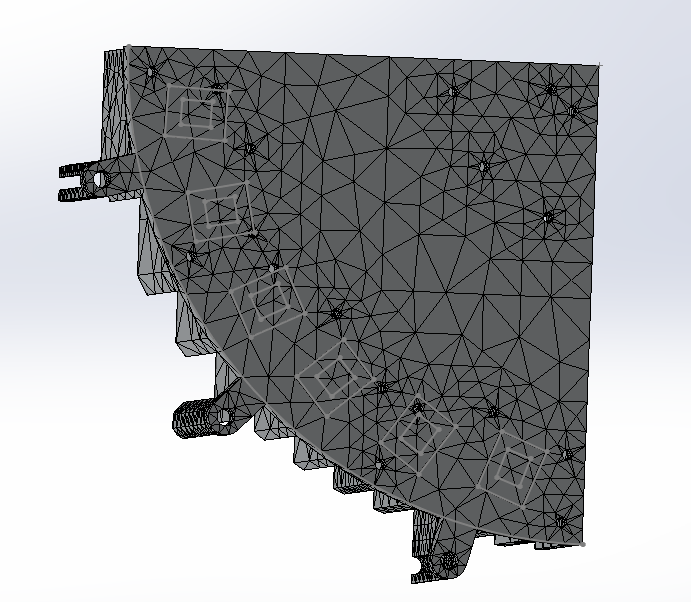
[picture p72: figure]
