nailtosun/Thermal-Analysis/FEA/pazargunu-Thermal 1-Image-1.jpg

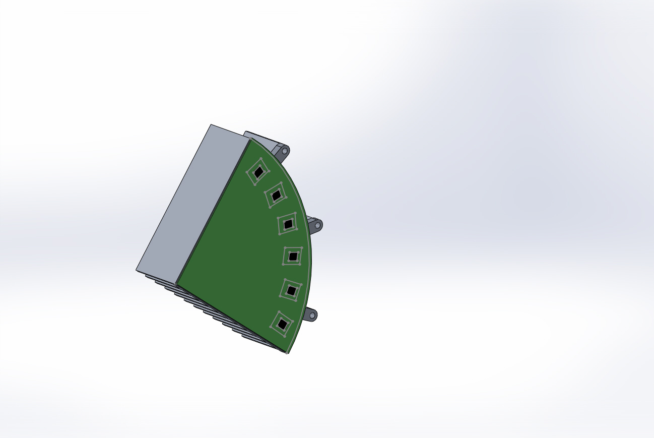
FEA/pazargunu-Thermal 1-Image-1.jpg
