nailtosun/Thermal-Analysis/FEA/pazargunu-Thermal 1/pazargunu-Thermal 1-Image-2.png

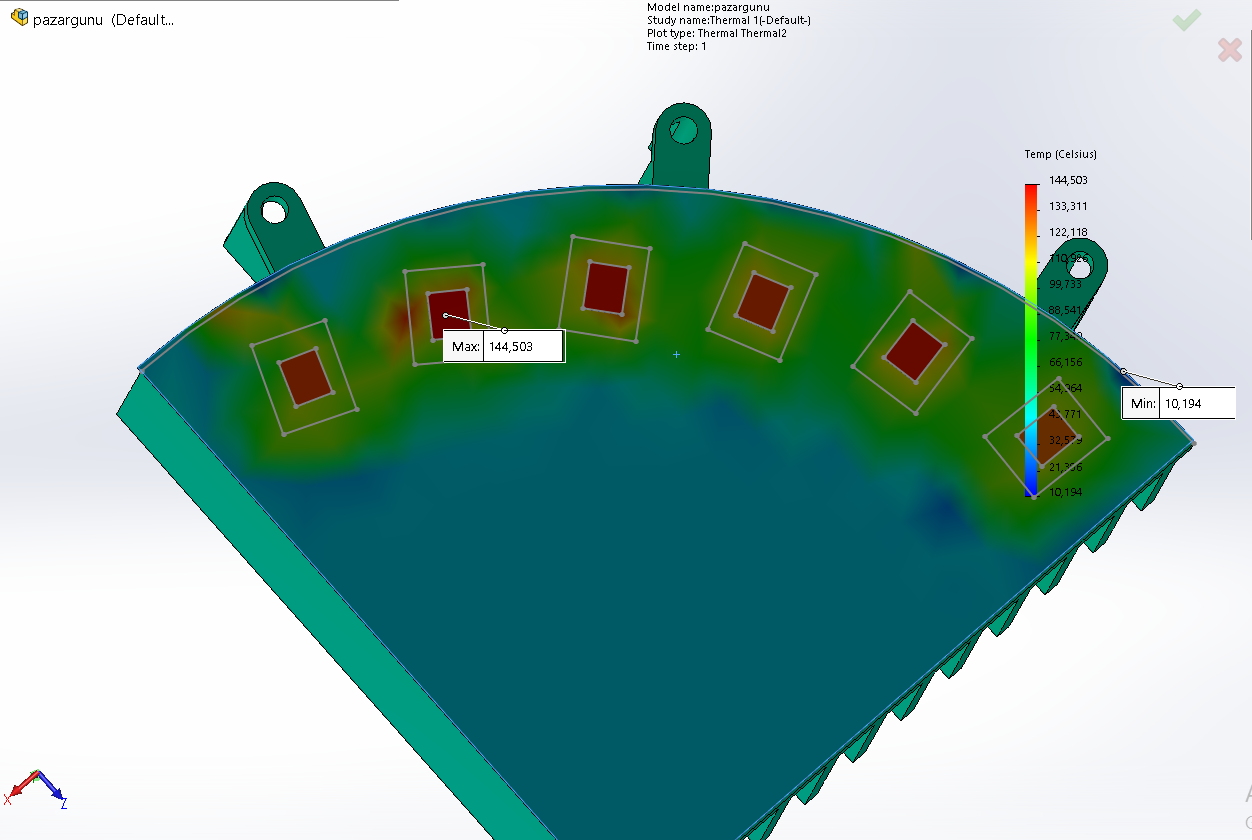
FEA/pazargunu-Thermal 1/pazargunu-Thermal 1-Image-2.png
