nailtosun/Thermal-Analysis/Excel/table.xlsx

Sheet: Sayfa1
Product Name | Dimension | Price $ | Unit Price per Gan | Thermal Conductivity z | Thermal Resistance (K/W) | Thermal Conductivity xy | Compressible | Thinkness | Key-Number
T-62 | 310 mm x 310 mm | 14.86 | 0.09664412071 | 20 W/m-K | 0.0104 | 400 W/m-K | No | 0.13mm | 1168-1412-ND
Soft PGS | 308 mm x 140 mm | 69.33 | 1.046648551 | 28 W/m-K | 0.01142857143 | 400 W/m-K | Yes | 0.2 mm | P121978-ND
PGS | 230 mmx 180 mm | 66.64 | 1.006038647 | 28 W/m-K | 0.004 | 1300W/m-K | No | 0.07mm | P19084-ND
1mm | 199 mm x 199mm | 63.48 | 1.00186864 | 6 W/m-K | 0.2642666667 | Not Defined |  | 0.991mm
1.5mm | 199 mm x 199mm | 66.25 | 1.04558597 | 5 W/m-K | 0.48 | Not Defined |  | 1.5 mm
2mm | 199 mm x 199mm | 76.7 | 1.210512361 | 5 W/m-K | 0.64 | Not Defined |  | 2mm
 |  | 66.24
Gan Area |  |  |  | Conductivity W/m-K | length (z direction) meter | Area meter^2
6.25 | 63.3616 |  |  | 20 | 0.00013 | 0.000625 | 0.0104
0.0001 |  |  |  | 28 | 0.0002 | 0.000625 | 0.01142857143
0.000625 |  |  |  | 28 | 7e-05 | 0.000625 | 0.004
 |  |  |  | 6 | 0.000991 | 0.000625 | 0.2642666667
 |  |  |  | 5 | 0.0015 | 0.000625 | 0.48
 |  |  |  | 5 | 0.002 | 0.000625 | 0.64

Sheet: Sayfa2
Product Name | Dimension | Price $ | Unit Price per Gan | Thermal Conductivity z direction | Thermal Resistance (K/W) | Thermal Conductivity xy | Thinkness | Key-Number
T-62 | 310 mm x 310 mm | 14.86 | 0.09664412071 | 20 W/m-K | 0.0104 | 400 W/m-K | 0.13mm | 1168-1412-ND
Soft PGS | 308 mm x 140 mm | 69.33 | 1.046648551 | 28 W/m-K | 0.01142857143 | 400 W/m-K | 0.2 mm | P121978-ND
PGS | 230 mmx 180 mm | 66.64 | 1.006038647 | 28 W/m-K | 0.004 | 1300W/m-K | 0.07mm | P19084-ND
1mm | 199 mm x 199mm | 63.48 | 1.00186864 | 6 W/m-K | 0.2642666667 | Not Defined | 0.991mm
1.5mm | 199 mm x 199mm | 66.25 | 1.04558597 | 5 W/m-K | 0.48 | Not Defined | 1.5 mm
2mm | 199 mm x 199mm | 76.7 | 1.210512361 | 5 W/m-K | 0.64 | Not Defined | 2mm

Sheet: Sayfa3
48 | 0.369
43 | 0.4071
38 | 0.454
33 | 0.5131
28 | 0.5898
23 | 0.6936
18 | 0.8416
