nailtosun/Thermal-Analysis/FEA/pazargunu.SLDASM

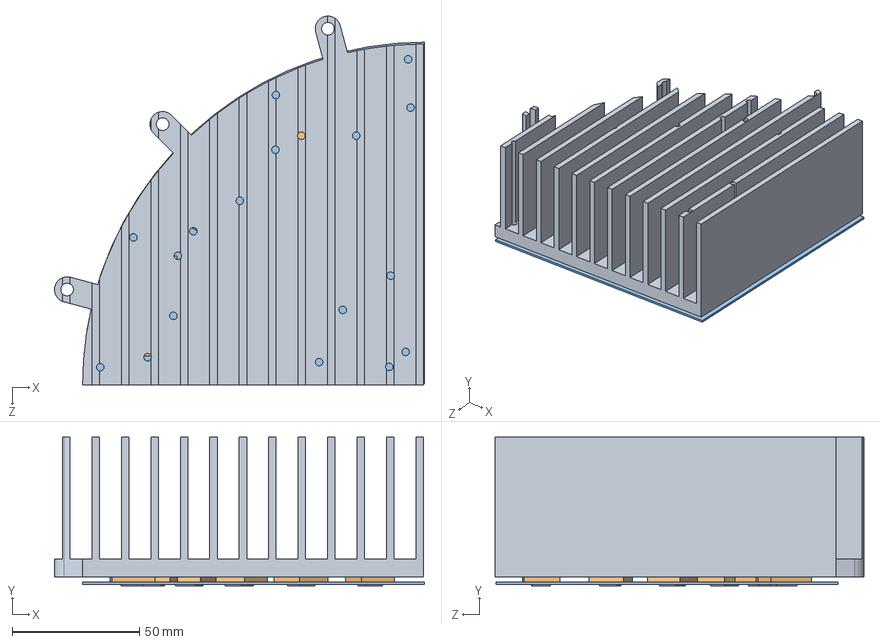
[picture p75: CAD file, 2018-12-10]
FEA/pazargunu.SLDASM
145.5 x 58.6 x 145.1 mm
Heat_sink_materialli
thermal-iso x 6
PCB
Gan x 6
