nailtosun/Thermal-Analysis/FEA/extrude5.SLDASM

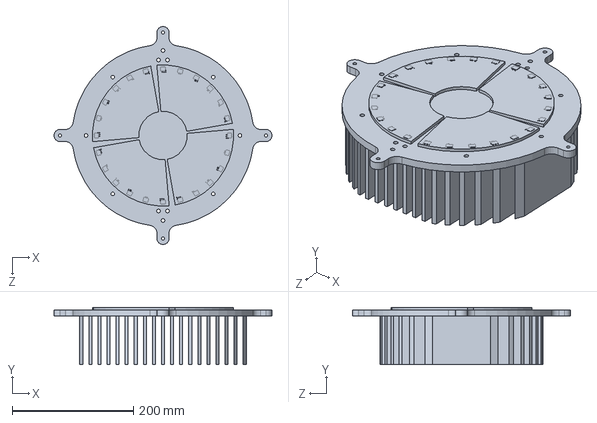
[picture p76: CAD file, 2018-11-26]
FEA/extrude5.SLDASM
360.0 x 94.5 x 360.0 mm
