nailtosun/Thermal-Analysis/FEA/FEA4ekim.SLDASM

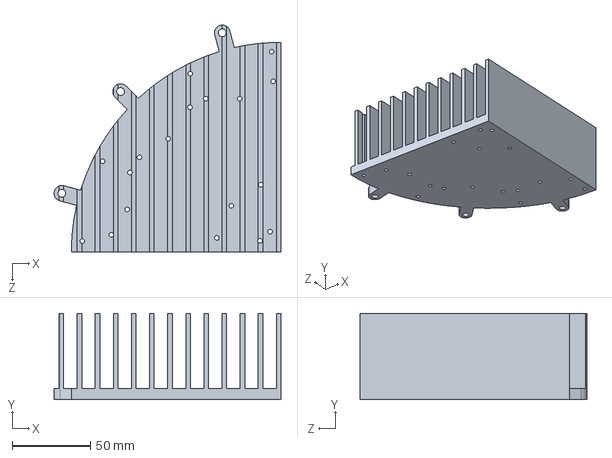
[picture p77: CAD file, 2018-11-26]
FEA/FEA4ekim.SLDASM
145.1 x 55.0 x 145.1 mm
