nailtosun/Thermal-Analysis/FEA/Assem1.SLDASM

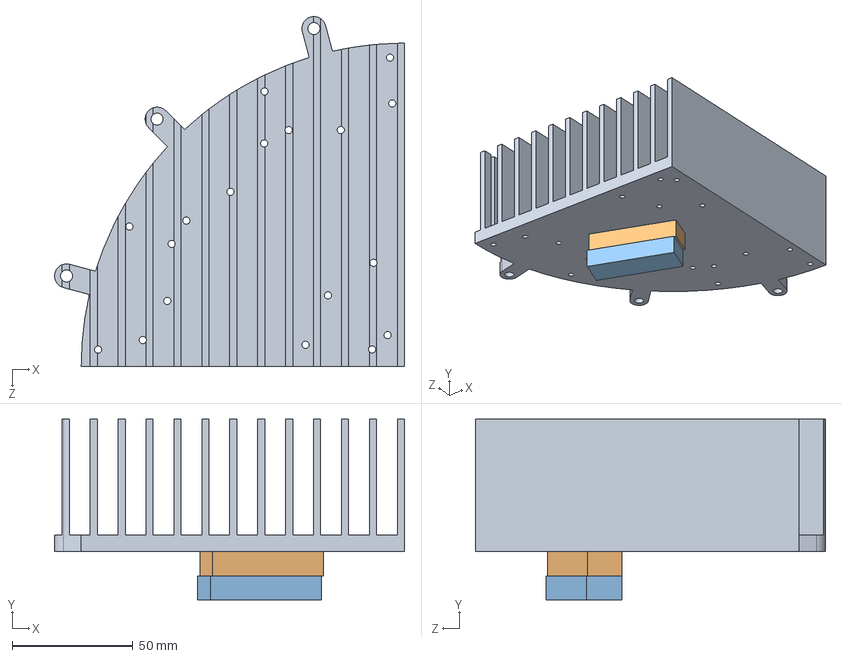
[picture p78: CAD file, 2018-11-26]
FEA/Assem1.SLDASM
145.1 x 75.0 x 145.1 mm
HeatSinkOneModule
paste2
metalresistor
