nailtosun/Thermal-Analysis/FEA/PCB.SLDPRT

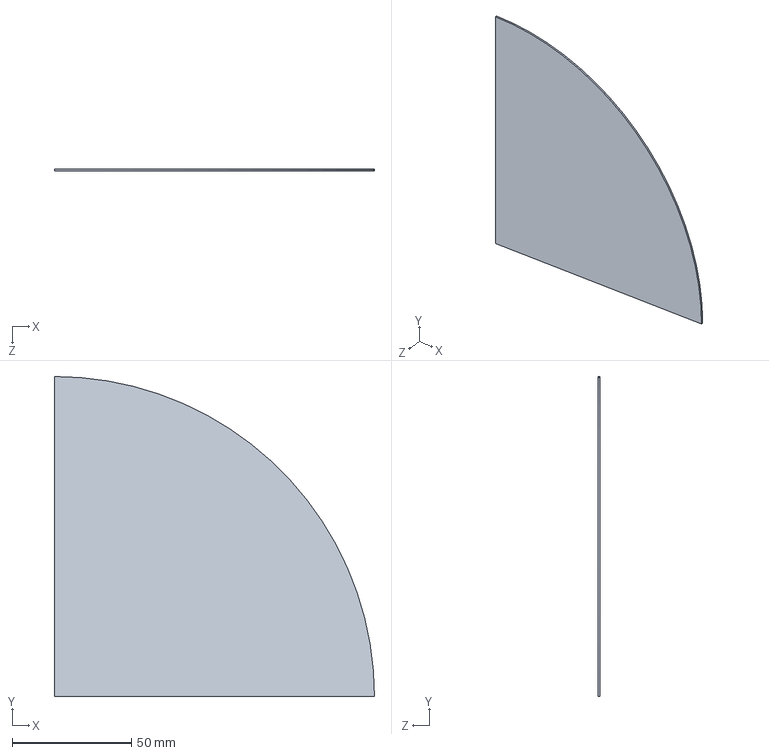
[picture p79: CAD file, 2018-12-10]
FEA/PCB.SLDPRT
134.4 x 134.4 x 1.00 mm
