nailtosun/Thermal-Analysis/FEA/Gan.SLDPRT

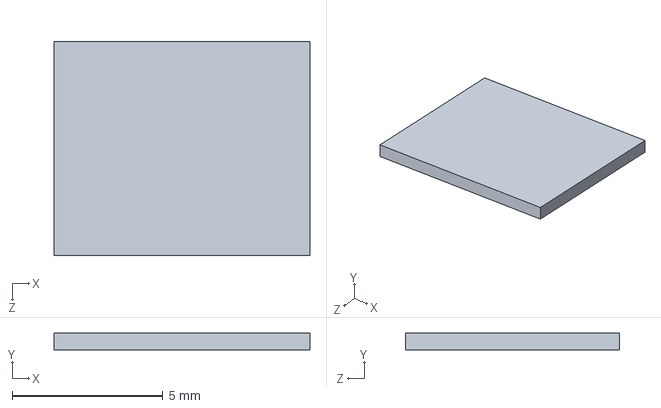
[picture p80: CAD file, 2018-12-02]
FEA/Gan.SLDPRT
8.50 x 0.56 x 7.10 mm
