nailtosun/Thermal-Analysis/FEA/thermal-iso.SLDPRT

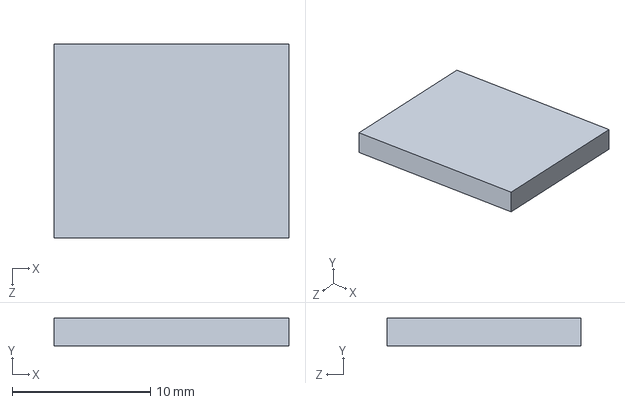
[picture p81: CAD file, 2018-12-02]
FEA/thermal-iso.SLDPRT
17.0 x 2.00 x 14.0 mm
