nailtosun/Thermal-Analysis/FEA/termal_macun.SLDPRT

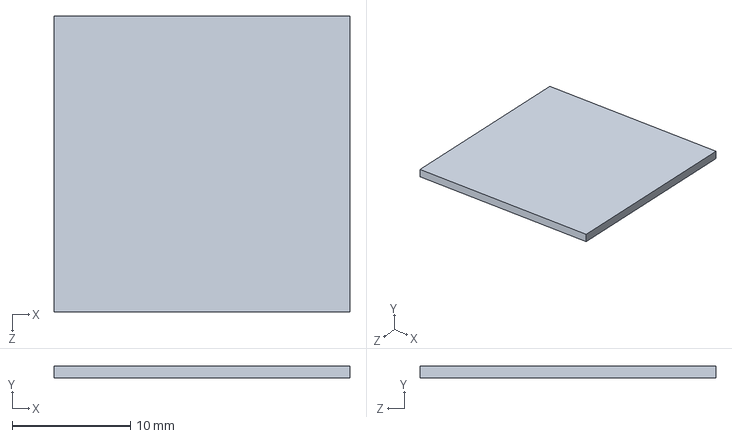
[picture p82: CAD file, 2018-11-26]
FEA/termal_macun.SLDPRT
25.0 x 1.00 x 25.0 mm
