nailtosun/Thermal-Analysis/FEA/metalresistor.SLDPRT

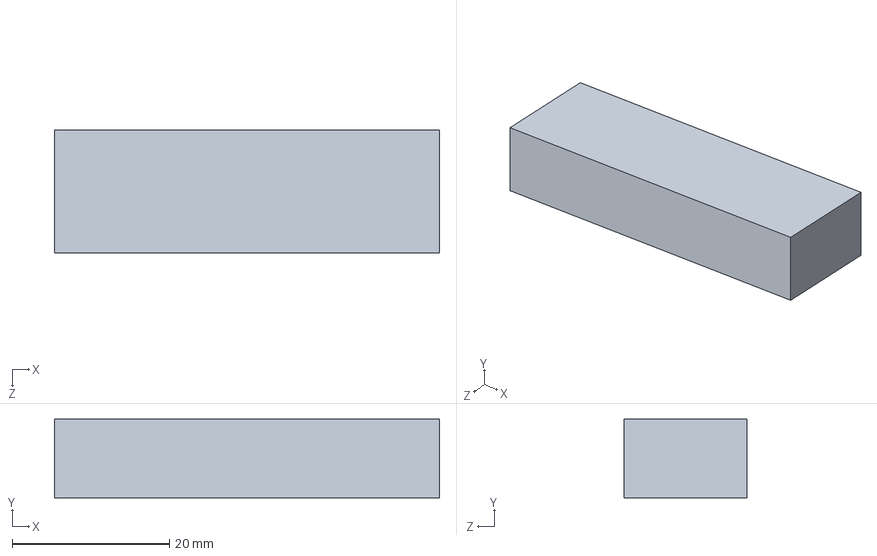
[picture p83: CAD file, 2018-11-26]
FEA/metalresistor.SLDPRT
49.0 x 10.0 x 15.7 mm
