nailtosun/Thermal-Analysis/FEA/paste.SLDPRT

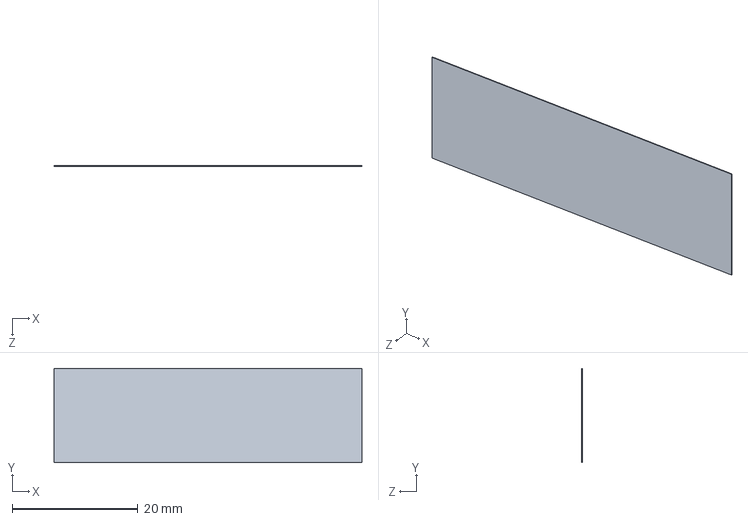
[picture p84: CAD file, 2018-11-26]
FEA/paste.SLDPRT
49.0 x 15.0 x 0.1 mm
