nailtosun/Thermal-Analysis/FEA/Part3.SLDPRT

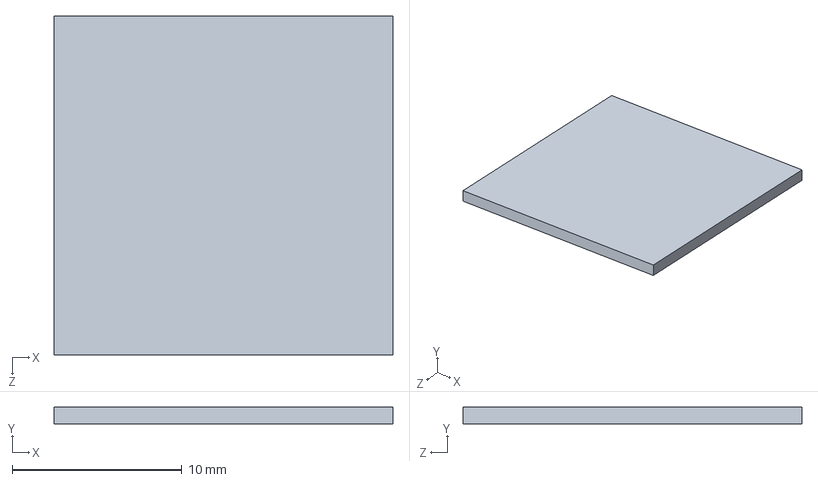
[picture p85: CAD file, 2018-11-26]
FEA/Part3.SLDPRT
20.0 x 1.00 x 20.0 mm
