nailtosun/Thermal-Analysis/FEA/paste2.SLDPRT

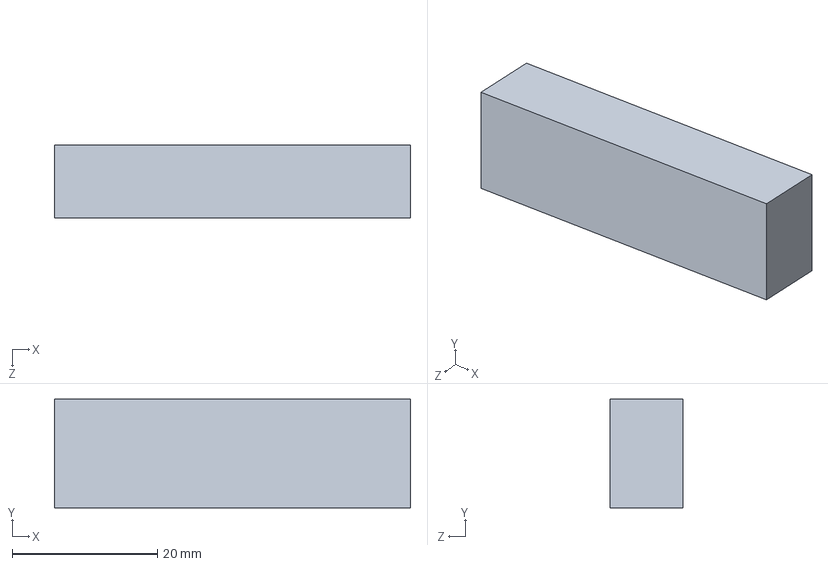
[picture p86: CAD file, 2018-11-26]
FEA/paste2.SLDPRT
49.0 x 15.0 x 10.0 mm
