nailtosun/Thermal-Analysis/FEA/HeatSinkOneModule1.SLDPRT

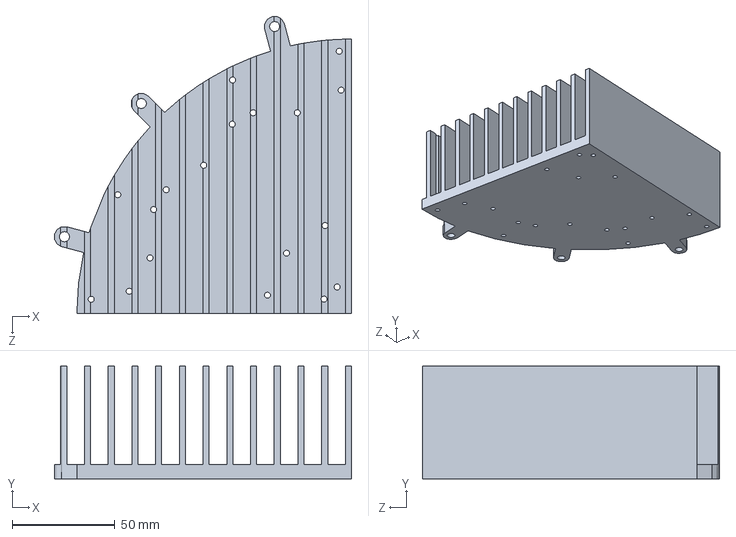
[picture p87: CAD file, 2018-11-26]
FEA/HeatSinkOneModule1.SLDPRT
144.9 x 55.0 x 145.1 mm
