nailtosun/Thermal-Analysis/FEA/thermallayer.SLDPRT

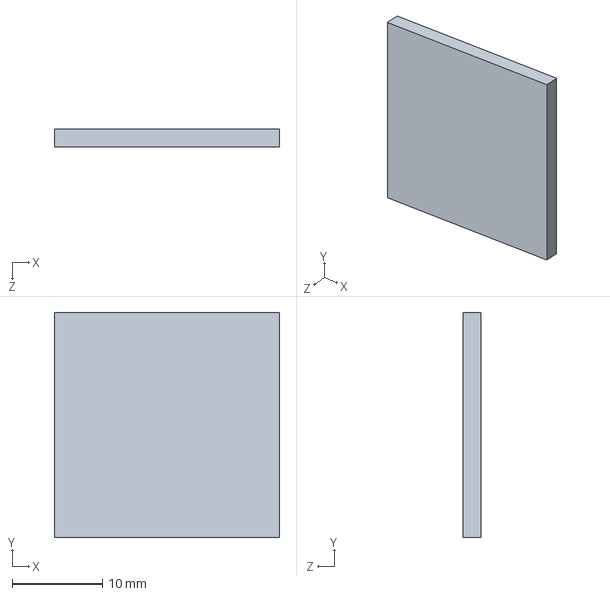
[picture p88: CAD file, 2018-11-26]
FEA/thermallayer.SLDPRT
25.0 x 25.0 x 2.00 mm
