nailtosun/Thermal-Analysis/(list of files, cad)

Other CAD files:
FEA/Assem31.SLDASM
FEA/Assem3.sldasm
FEA/HeatSinkOneModule2.SLDPRT
FEA/asasa.SLDPRT
FEA/Heat_sink_materialli.SLDPRT
FEA/PCBv2.SLDPRT
FEA/HeatSinkOneModule.SLDPRT
FEA/thermal_pad.SLDPRT
FEA/A21112018.SLDASM
FEA/HeatSinkOneModule.STL
