nailtosun/Thermal-Analysis/FEA/model.PDF

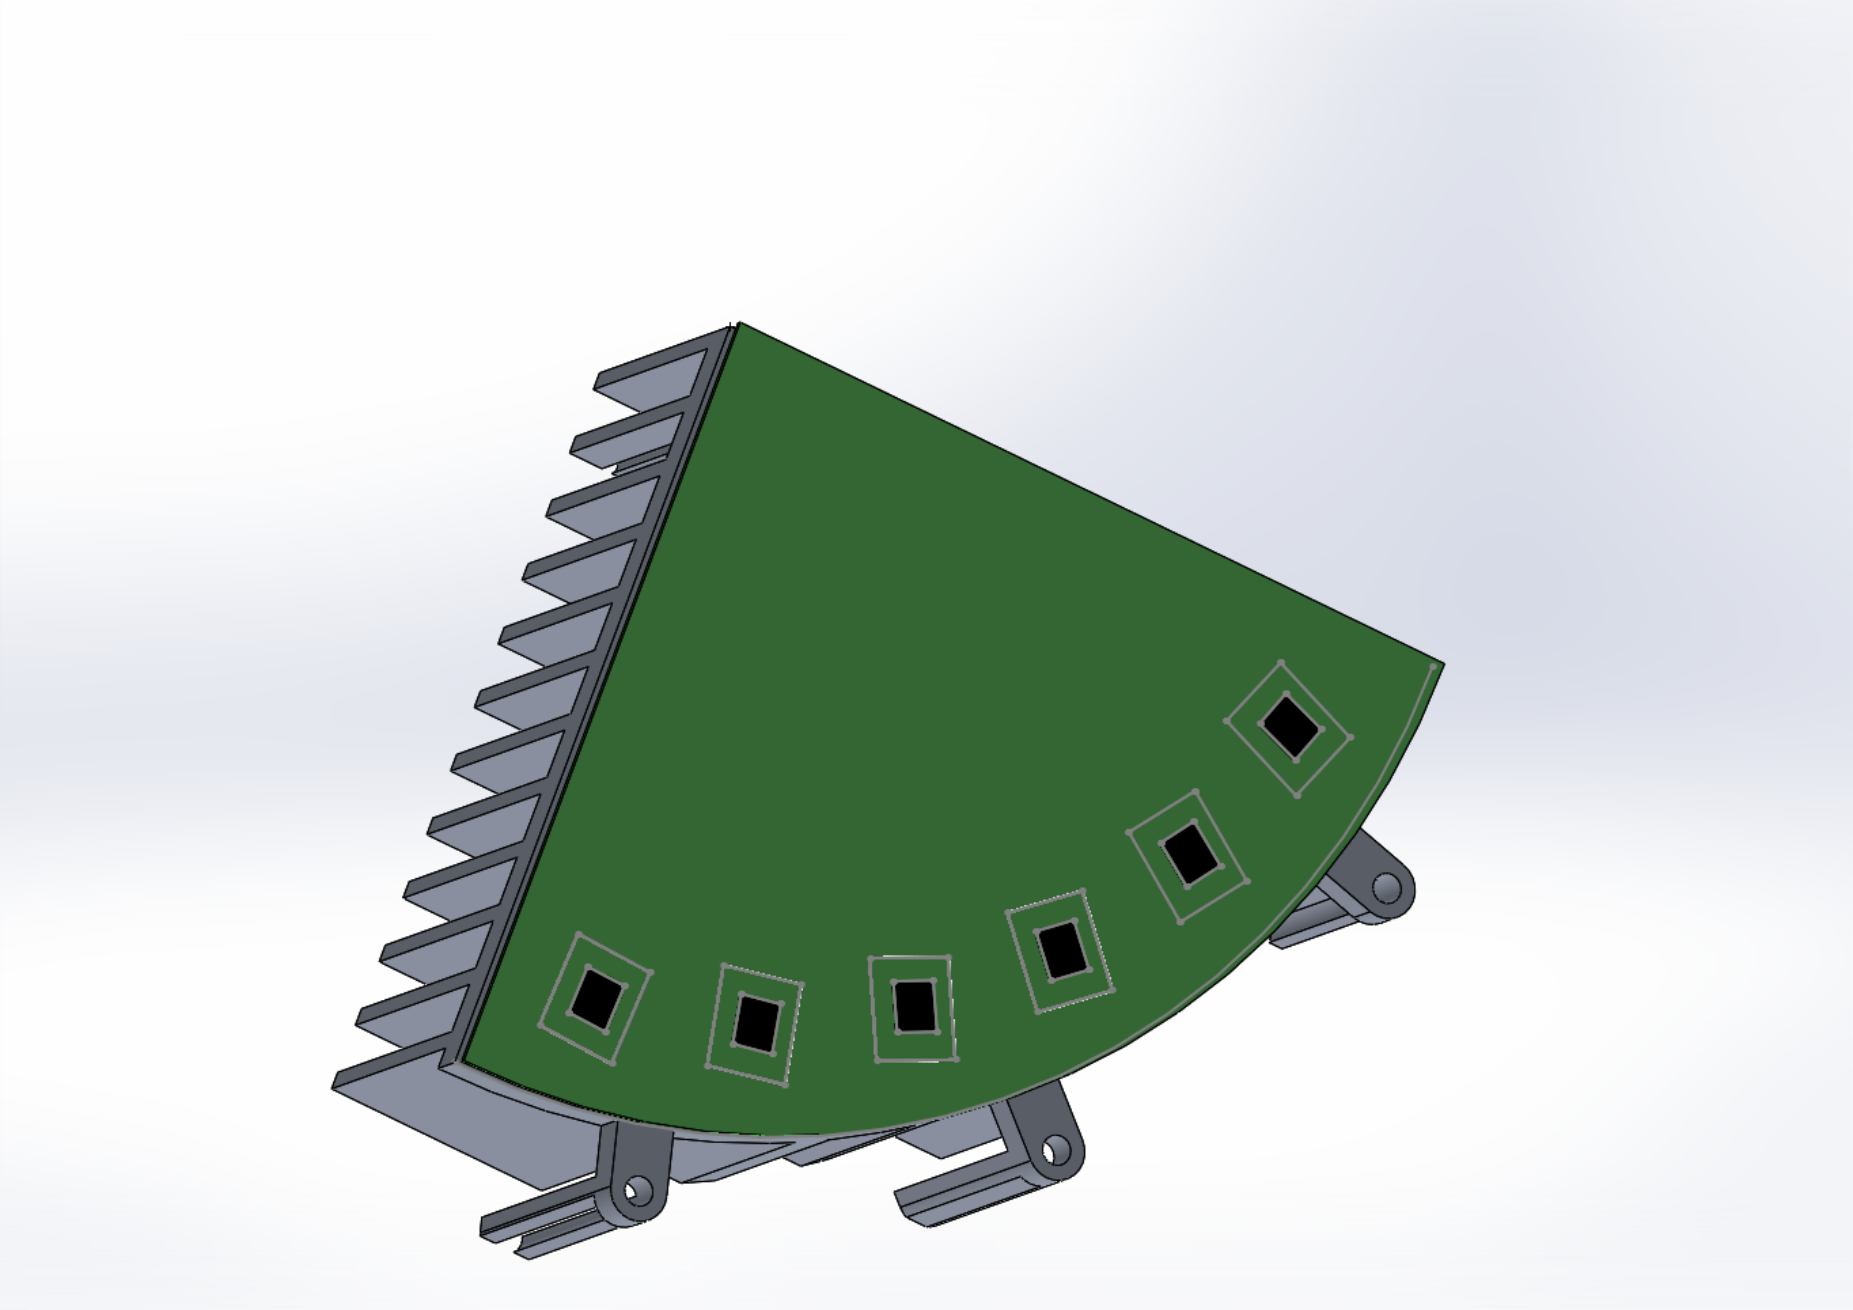
[picture p89: page 1]
