nailtosun/Thermal-Analysis/(commit log)

2018-07-15 Heat sink çizimi yenilendi
    [Heat-sink.stp]
2018-08-29 big commit
    [Part1.SLDPRT, table.xlsx]
2018-10-03 gereksiz dosyaların silimi
    [Heat-sink.SLDPRT, Heat-sink.stp, Part1.SLDPRT, Part3.SLDPRT, bending-attach.SLDPRT, heatsink.sldprt, heatsink2.sldprt, heatsinkwithceramic.stp]
2018-11-26 Thermal setup installed, connection problem
    [A21112018.SLDASM, Assem1.SLDASM, Assem3.sldasm, Assem31.SLDASM, FEA4ekim.SLDASM, Gan.SLDPRT, HeatSinkOneModule.SLDPRT, HeatSinkOneModule.STL]
2018-11-26 Contact problem fixed by still make no sense
    [A21112018.SLDASM]
2018-11-28 Problem solved FR4 conductivity 0.25 girildi
    [A21112018.SLDASM, Gan.SLDPRT]
2018-12-02 second iteration done
    [Gan.SLDPRT, PCB.SLDPRT, pazargunu.SLDASM, thermal-iso.SLDPRT]
2018-12-10 presentation added, mathematical derivation of natural cooling added(.m file)
    [PCB.SLDPRT, pazargunu.SLDASM]
